naraprajwal/NeuraCorePCB/zynqPCB/images/blockdiagram_edited.png

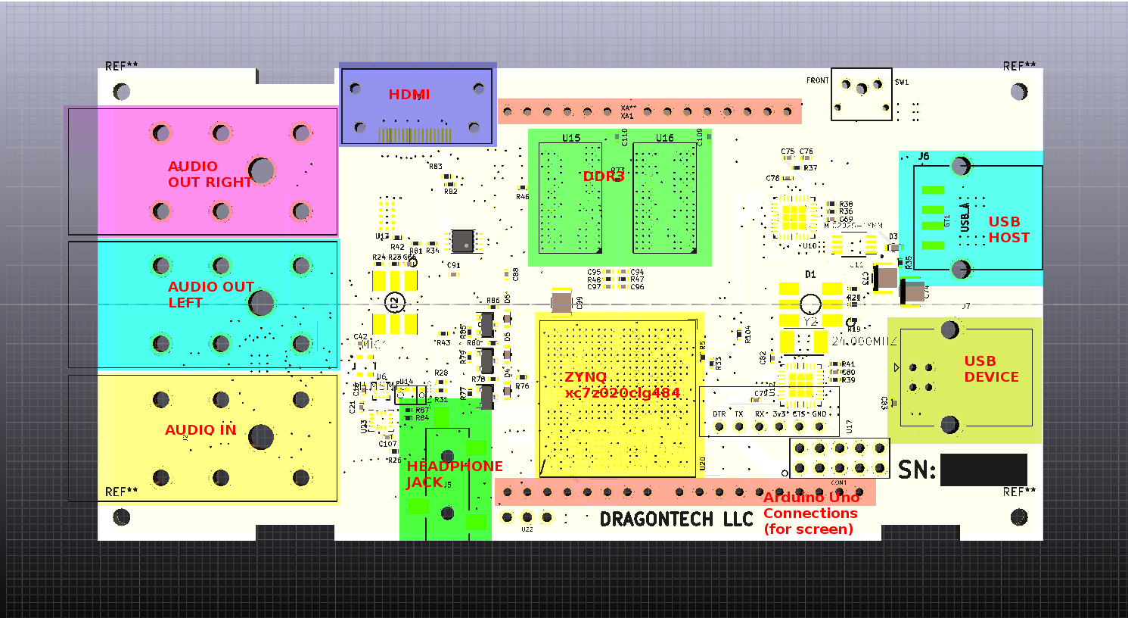
zynqPCB/images/blockdiagram_edited.png
