naraprajwal/NeuraCorePCB/zynqPCB/images/dt01_v3_bottom.jpg

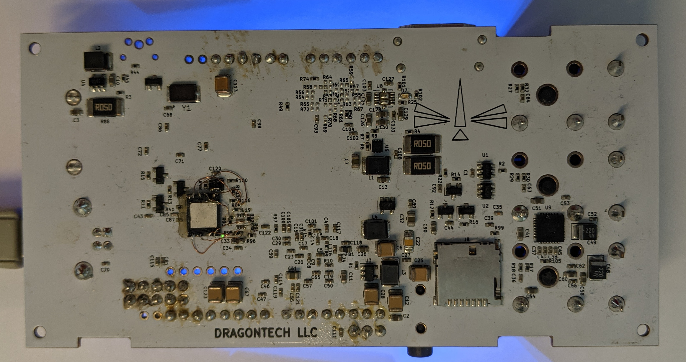
zynqPCB/images/dt01_v3_bottom.jpg
