naraprajwal/NeuraCorePCB/README.md

# NeuraCore-PCB
PCB design, Schematic, Libs etc
