naraprajwal/NeuraCorePCB/zynqPCB/docs/jackdetection.gif

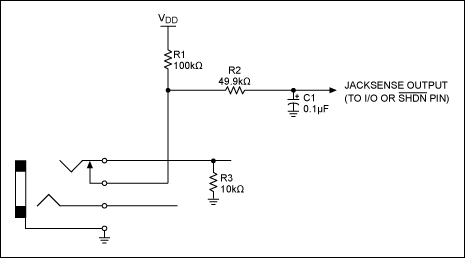
zynqPCB/docs/jackdetection.gif
