naraprajwal/NeuraCorePCB/zynqPCB/images/blockdiagram.PNG

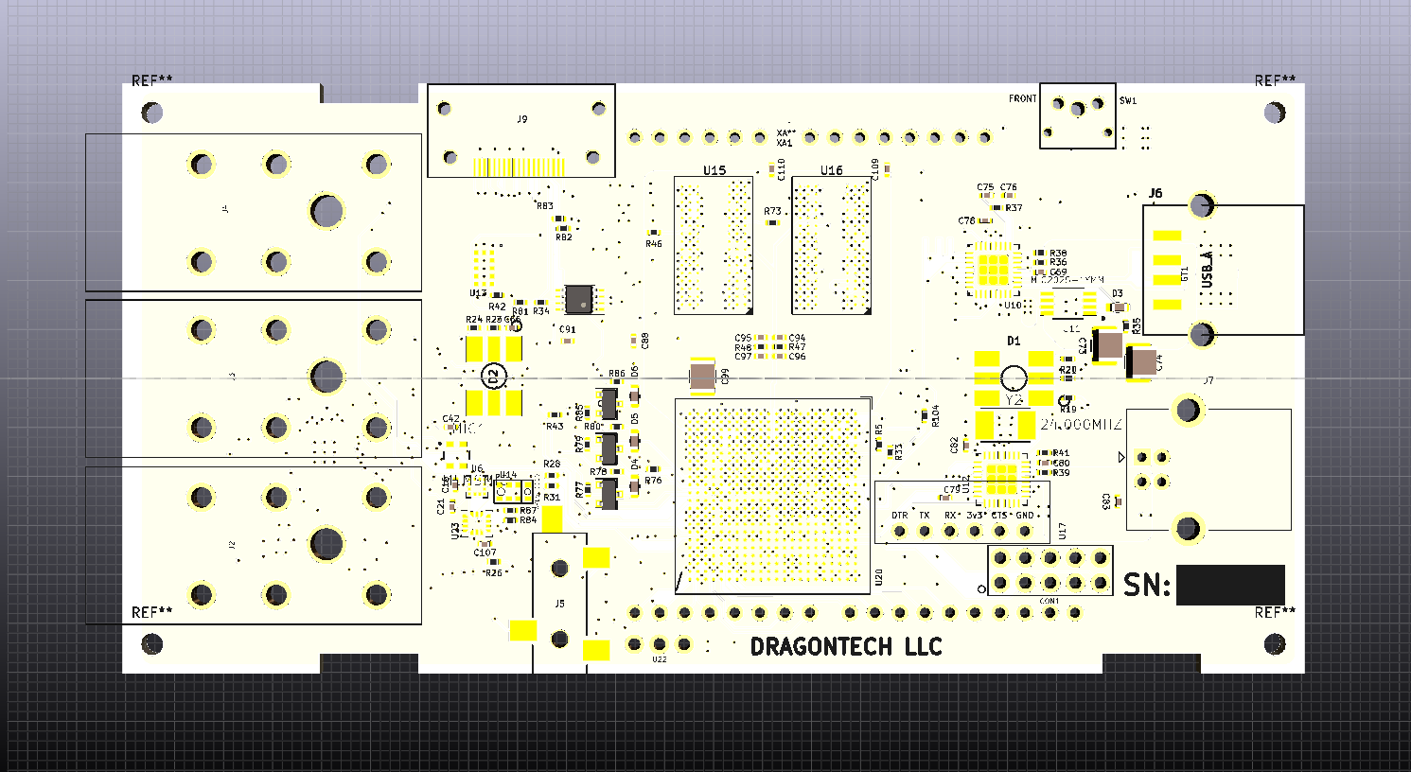
zynqPCB/images/blockdiagram.PNG
