naraprajwal/NeuraCorePCB/zynqPCB/images/dt01_3drender.PNG

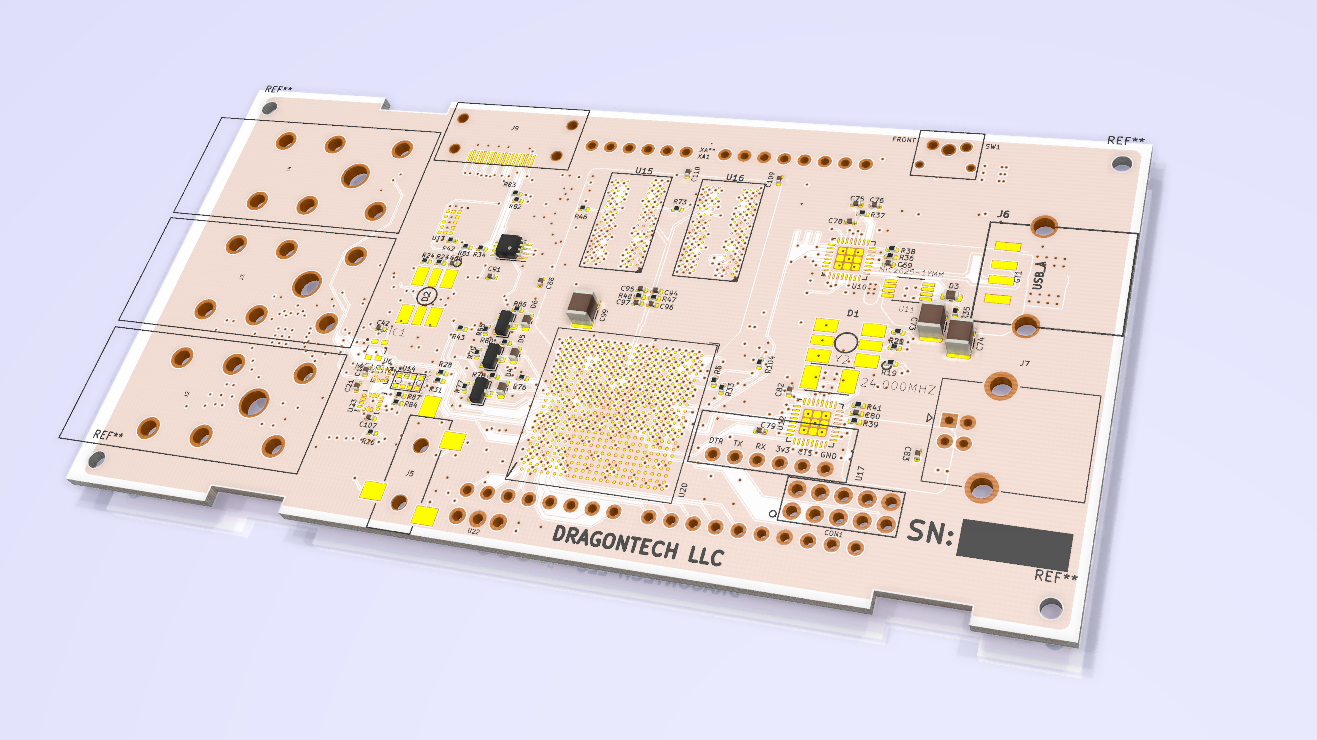
zynqPCB/images/dt01_3drender.PNG
