naraprajwal/NeuraCorePCB/zynqPCB/images/dt01_schematic.PNG

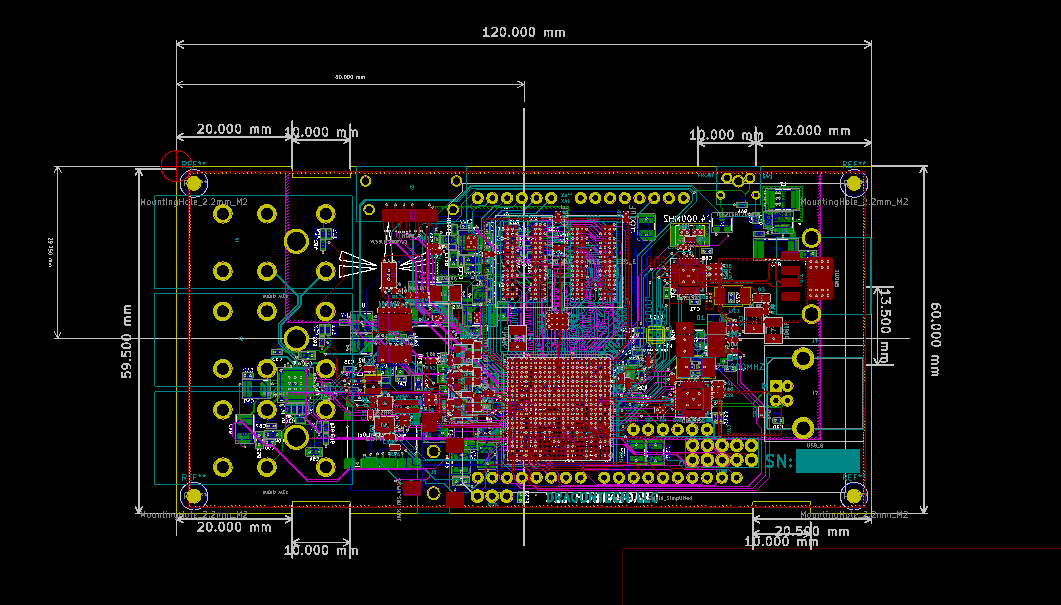
zynqPCB/images/dt01_schematic.PNG
