naraprajwal/NeuraCorePCB/zynqPCB/images/dt01_v3_top.jpg

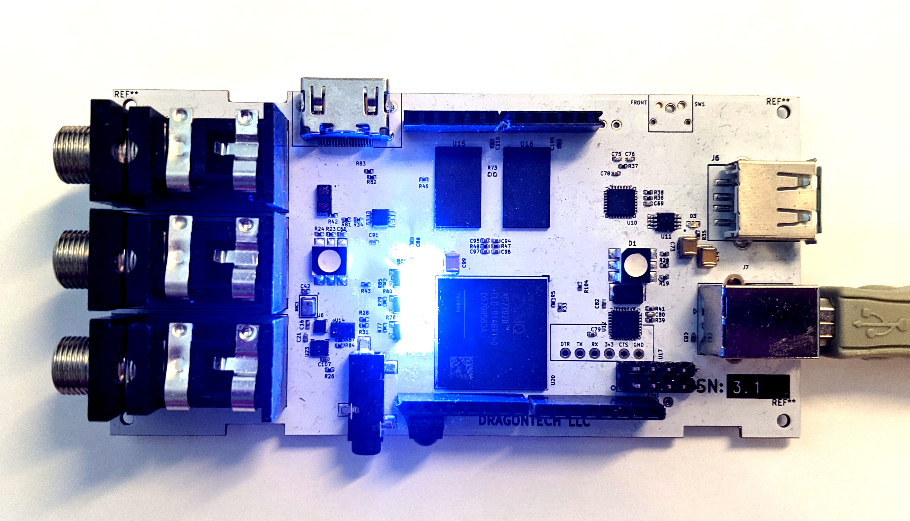
zynqPCB/images/dt01_v3_top.jpg
