naraprajwal/NeuraCorePCB/(list of files, drawings)

Other design files:
zynqPCB/DFTBoard.dsn
