naraprajwal/NeuraCorePCB/zynqPCB/Camera.kicad_sch

## KiCad design zynqPCB/Camera.kicad_sch (2026-04-15)

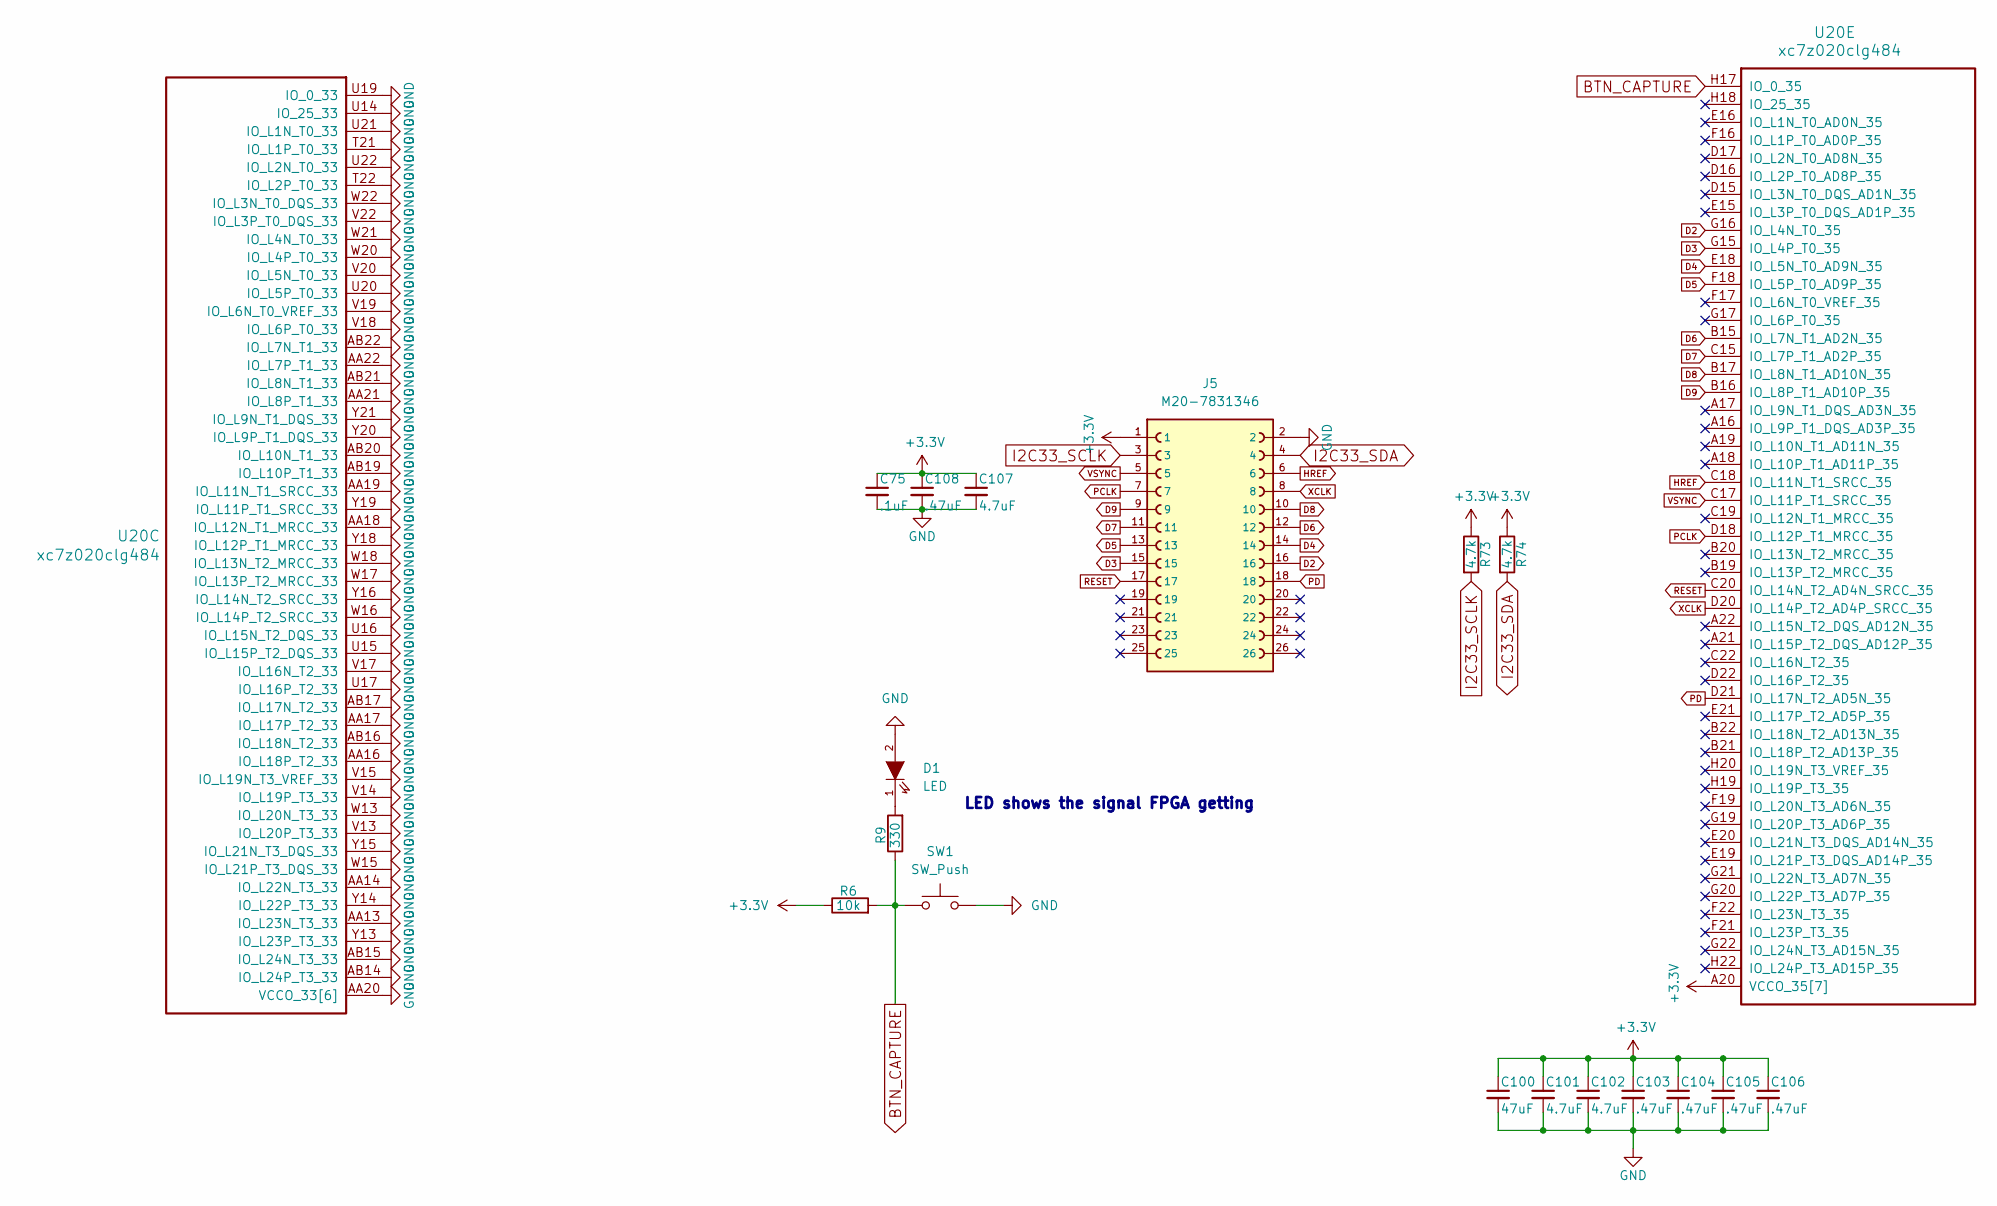
[picture p9: schematic Camera.kicad_sch]

Parts:
C75: .1uF; C_0402_1005Metric; MPN CC0402KRX7R6BB104
C100: 47uF; C_1210_3225Metric; MPN GRM32ER70J476ME20L
C101, C102, C107: 4.7uF; C_0402_1005Metric; MPN GRM155R60G475ME47D
C103, C104, C105, C106, C108: .47uF; C_0402_1005Metric; MPN CC0402KRX5R5BB474
D1: LED; LED_0603_1608Metric
J5: M20-7831346; HARWIN_M20-7831346; DigiKey_Part_Number 952-2548-ND
R6: 10k; R_0402_1005Metric
R9: 330; R_0603_1608Metric
R73, R74: 4.7k; R_0402_1005Metric; MPN RC0402JR-074K7L
SW1: SW_Push; SW_SPST_TL3342
U20: xc7z020clg484; BGA-484_19.0x19.0mm_Layout22x22_P0.80mm_dia0.40mm; MPN XC7Z020-1CLG484C

Connections:
+3.3V: C75.1, C100.1, C101.1, C102.1, C103.1, C104.1, C105.1, C106.1, C107.1, C108.1, J5.1, R6.1, R73.1, R74.1, U20.A20 (VCCO_35[7]), U20.C16 (VCCO_35[7]), U20.D19 (VCCO_35[7]), U20.E22 (VCCO_35[7]), U20.F15 (VCCO_35[7]), U20.G18 (VCCO_35[7]), U20.H21 (VCCO_35[7])
BTN_CAPTURE: R6.2, R9.1, SW1.1, U20.H17 (IO_0_35)
D2: J5.16, U20.G16 (IO_L4N_T0_35)
D3: J5.15, U20.G15 (IO_L4P_T0_35)
D4: J5.14, U20.E18 (IO_L5N_T0_AD9N_35)
D5: J5.13, U20.F18 (IO_L5P_T0_AD9P_35)
D6: J5.12, U20.B15 (IO_L7N_T1_AD2N_35)
D7: J5.11, U20.C15 (IO_L7P_T1_AD2P_35)
D8: J5.10, U20.B17 (IO_L8N_T1_AD10N_35)
D9: J5.9, U20.B16 (IO_L8P_T1_AD10P_35)
GND: C75.2, C100.2, C101.2, C102.2, C103.2, C104.2, C105.2, C106.2, C107.2, C108.2, D1.2 (A), J5.2, SW1.2, U20.AA13 (IO_L23N_T3_33), U20.AA14 (IO_L22N_T3_33), U20.AA16 (IO_L18P_T2_33), U20.AA17 (IO_L17P_T2_33), U20.AA18 (IO_L12N_T1_MRCC_33), U20.AA19 (IO_L11N_T1_SRCC_33), U20.AA20 (VCCO_33[6]), U20.AA21 (IO_L8P_T1_33), U20.AA22 (IO_L7P_T1_33), U20.AB13 (VCCO_33[6]), U20.AB14 (IO_L24P_T3_33), U20.AB15 (IO_L24N_T3_33), U20.AB16 (IO_L18N_T2_33), U20.AB17 (IO_L17N_T2_33), U20.AB19 (IO_L10P_T1_33), U20.AB20 (IO_L10N_T1_33), U20.AB21 (IO_L8N_T1_33), U20.AB22 (IO_L7N_T1_33), U20.T21 (IO_L1P_T0_33), U20.T22 (IO_L2P_T0_33), U20.U14 (IO_25_33), U20.U15 (IO_L15P_T2_DQS_33), U20.U16 (IO_L15N_T2_DQS_33), U20.U17 (IO_L16P_T2_33), U20.U18 (VCCO_33[6]), U20.U19 (IO_0_33), U20.U20 (IO_L5P_T0_33), U20.U21 (IO_L1N_T0_33), U20.U22 (IO_L2N_T0_33), U20.V13 (IO_L20P_T3_33), U20.V14 (IO_L19P_T3_33), U20.V15 (IO_L19N_T3_VREF_33), U20.V17 (IO_L16N_T2_33), U20.V18 (IO_L6P_T0_33), U20.V19 (IO_L6N_T0_VREF_33), U20.V20 (IO_L5N_T0_33), U20.V21 (VCCO_33[6]), U20.V22 (IO_L3P_T0_DQS_33), U20.W13 (IO_L20N_T3_33), U20.W14 (VCCO_33[6]), U20.W15 (IO_L21P_T3_DQS_33), U20.W16 (IO_L14P_T2_SRCC_33), U20.W17 (IO_L13P_T2_MRCC_33), U20.W18 (IO_L13N_T2_MRCC_33), U20.W20 (IO_L4P_T0_33), U20.W21 (IO_L4N_T0_33), U20.W22 (IO_L3N_T0_DQS_33), U20.Y13 (IO_L23P_T3_33), U20.Y14 (IO_L22P_T3_33), U20.Y15 (IO_L21N_T3_DQS_33), U20.Y16 (IO_L14N_T2_SRCC_33), U20.Y17 (VCCO_33[6]), U20.Y18 (IO_L12P_T1_MRCC_33), U20.Y19 (IO_L11P_T1_SRCC_33), U20.Y20 (IO_L9P_T1_DQS_33), U20.Y21 (IO_L9N_T1_DQS_33)
HREF: J5.6, U20.C18 (IO_L11N_T1_SRCC_35)
I2C33_SCLK: J5.3, R73.2
I2C33_SDA: J5.4, R74.2
unnamed: D1.1 (K), R9.2
PCLK: J5.7, U20.D18 (IO_L12P_T1_MRCC_35)
PD: J5.18, U20.D21 (IO_L17N_T2_AD5N_35)
RESET: J5.17, U20.C20 (IO_L14N_T2_AD4N_SRCC_35)
VSYNC: J5.5, U20.C17 (IO_L11P_T1_SRCC_35)
XCLK: J5.8, U20.D20 (IO_L14P_T2_AD4P_SRCC_35)

Notes on the sheet:
LED shows the signal FPGA getting
