naraprajwal/NeuraCorePCB/zynqPCB/DDR3.kicad_sch

## KiCad design zynqPCB/DDR3.kicad_sch (2026-04-15)

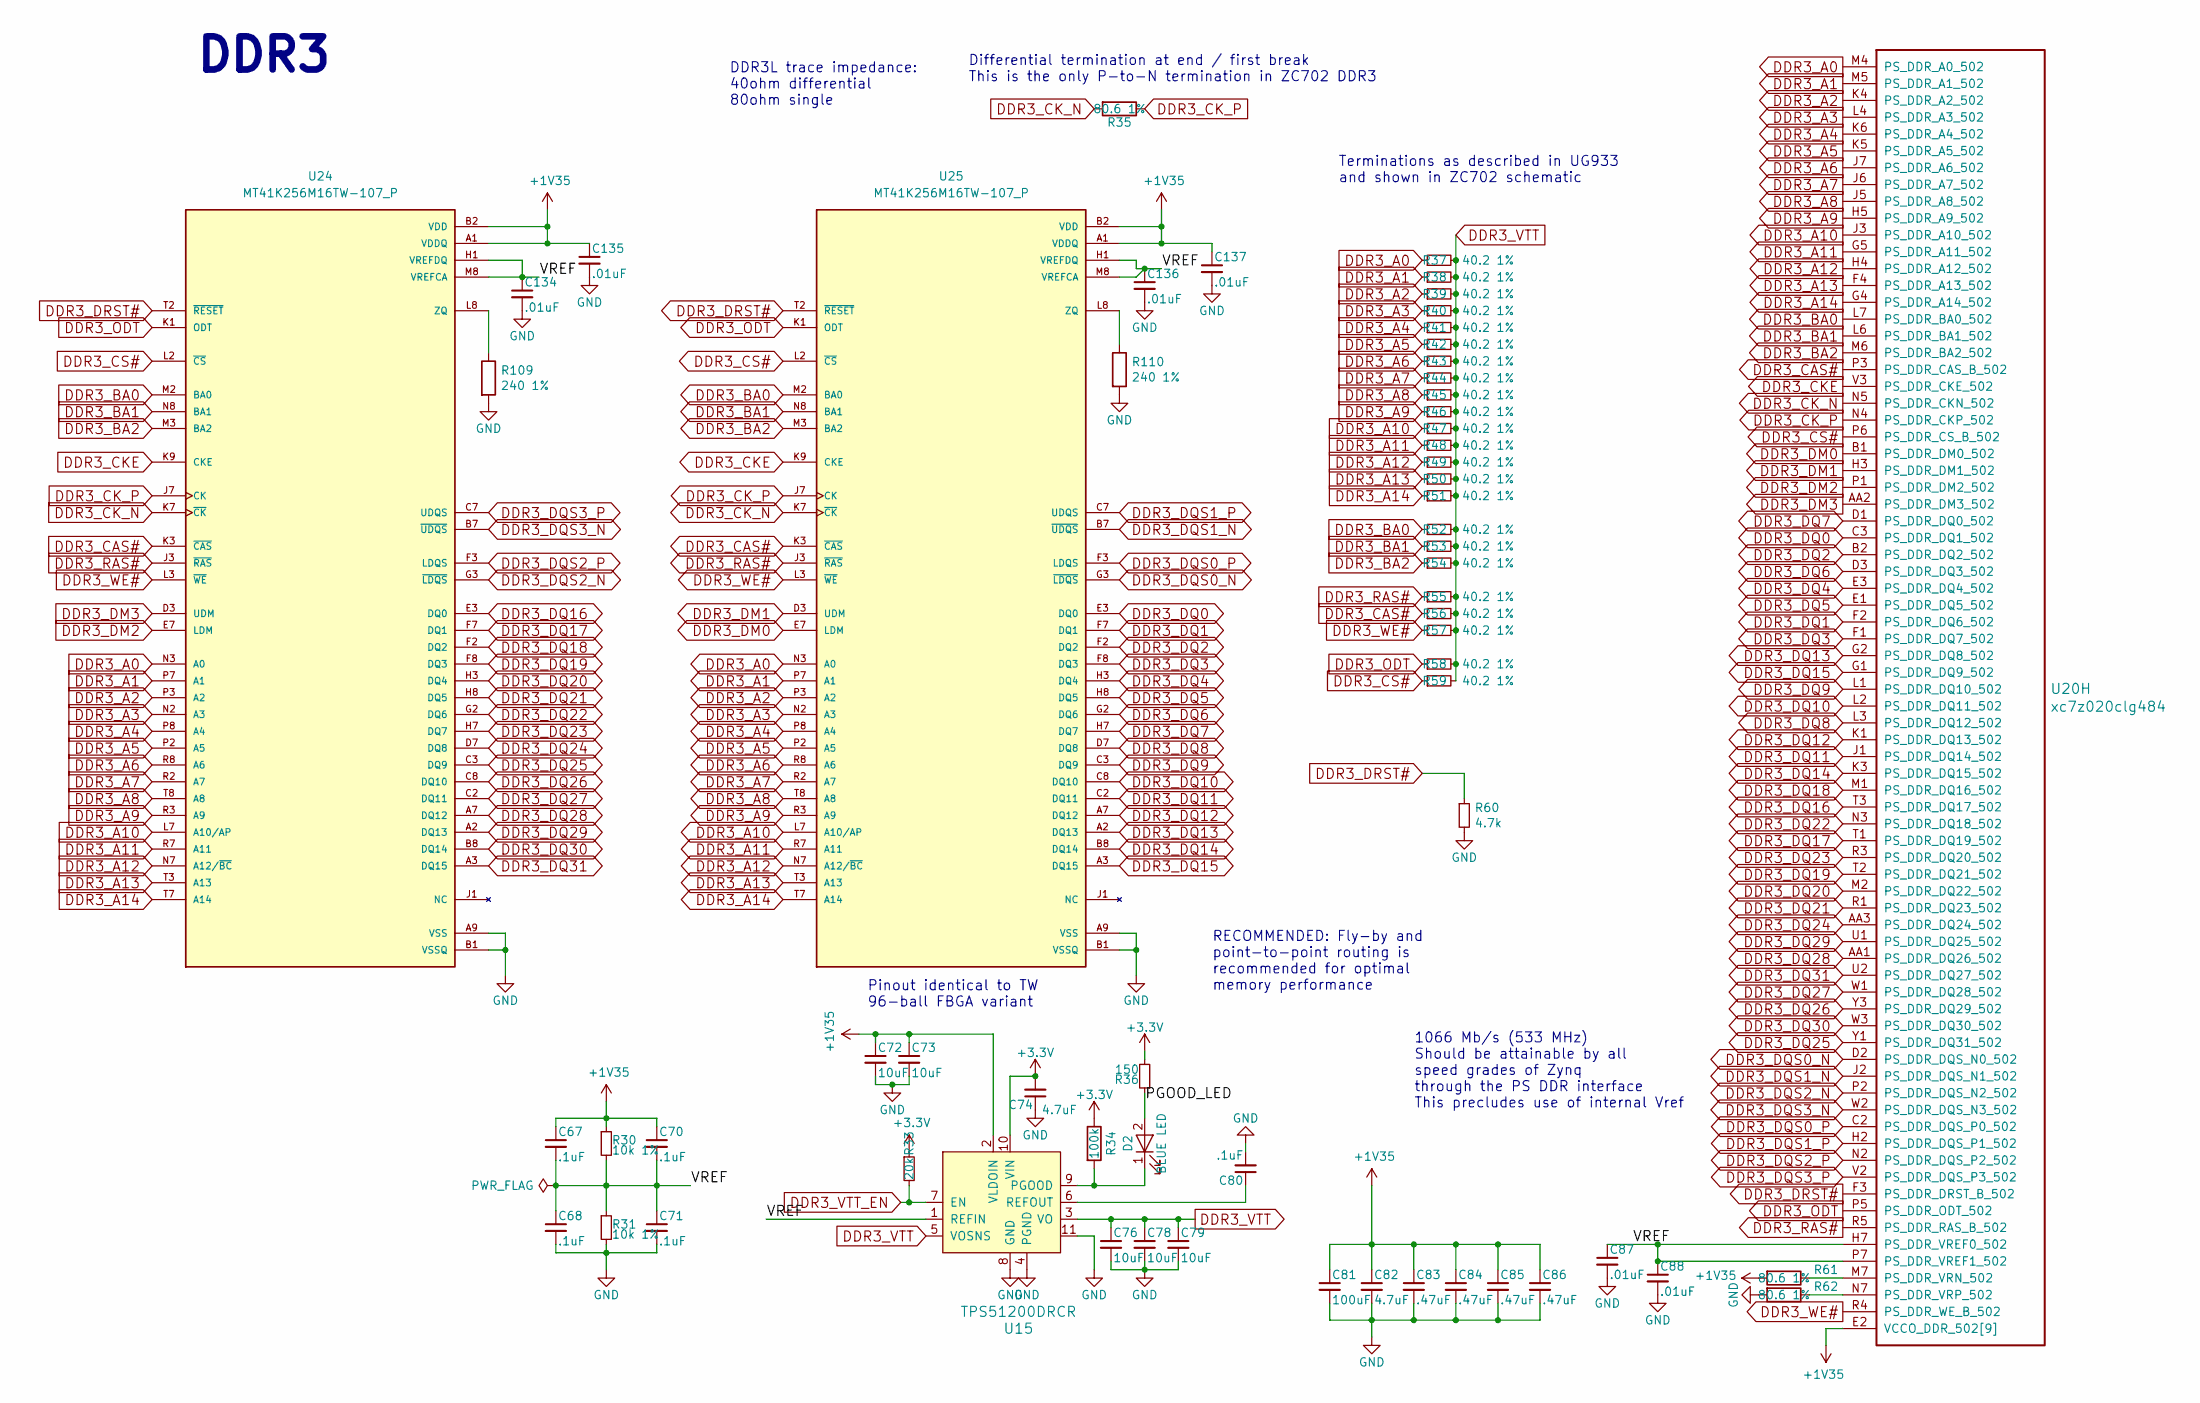
[picture p10: schematic DDR3.kicad_sch]

Parts:
C67, C68, C70, C71, C80: .1uF; C_0402_1005Metric; MPN CC0402KRX7R6BB104
C72, C73, C76, C78, C79: 10uF; C_0603_1608Metric; MPN GRM188R61A106KE69J
C74, C82: 4.7uF; C_0402_1005Metric; MPN GRM155R60G475ME47D
C81: 100uF; C_1210_3225Metric; MPN JMK325ABJ107MM-P
C83, C84, C85, C86: .47uF; C_0402_1005Metric; MPN CC0402KRX5R5BB474
C87, C88, C134, C135, C136, C137: .01uF; C_0402_1005Metric; MPN GRM155R71H103KA88J
D2: BLUE LED; C_0603_1608Metric; MPN VLMB1300-GS08
R30, R31: 10k 1%; R_0402_1005Metric; MPN RC0402FR-0710KL
R33: 20k; R_0402_1005Metric; MPN RT0402BRD0720KL
R34: 100k; R_0402_1005Metric; MPN RC0402FR-07100KL
R35, R61, R62: 80.6 1%; R_0402_1005Metric; MPN RC0402FR-0780R6L
R36: 150; R_0402_1005Metric; MPN RC0402FR-07150RL
R37, R38, R39, R40, R41, R42, R43, R44, R45, R46, R47, R48, R49, R50, R51, R52, R53, R54, R55, R56, R57, R58, R59: 40.2 1%; R_0402_1005Metric; MPN RC0402FR-0740R2L
R60: 4.7k; R_0402_1005Metric; MPN RC0402JR-074K7L
R109, R110: 240 1%; R_0402_1005Metric; MPN RC0402FR-07240RL
U15: TPS51200DRCR; VSON-10-1EP_3x3mm_P0.5mm_EP1.65x2.4mm_ThermalVias; MPN TPS51200DRCR; Digi-Key_PN 296-26978-1-ND
U20: xc7z020clg484; BGA-484_19.0x19.0mm_Layout22x22_P0.80mm_dia0.40mm; MPN XC7Z020-1CLG484C
U24, U25: MT41K256M16TW-107_P; MT41K256M16TW_107_P; PARTREV P; DigiKey_Part_Number 557-1792-ND

Connections:
+1V35: C67.1, C70.1, C72.1, C73.1, C81.1, C82.1, C83.1, C84.1, C85.1, C86.1, C135.1, C137.1, R30.1, R61.2, U15.2 (VLDOIN), U20.E2 (VCCO_DDR_502[9]), U20.F5 (VCCO_DDR_502[9]), U20.H1 (VCCO_DDR_502[9]), U20.J4 (VCCO_DDR_502[9]), U20.K7 (VCCO_DDR_502[9]), U20.M3 (VCCO_DDR_502[9]), U20.N6 (VCCO_DDR_502[9]), U20.R2 (VCCO_DDR_502[9]), U20.V1 (VCCO_DDR_502[9]), U24.A1 (VDDQ), U24.A8 (VDDQ), U24.B2 (VDD), U24.C1 (VDDQ), U24.C9 (VDDQ), U24.D2 (VDDQ), U24.D9 (VDD), U24.E9 (VDDQ), U24.F1 (VDDQ), U24.G7 (VDD), U24.H2 (VDDQ), U24.H9 (VDDQ), U24.K2 (VDD), U24.K8 (VDD), U24.N1 (VDD), U24.N9 (VDD), U24.R1 (VDD), U24.R9 (VDD), U25.A1 (VDDQ), U25.A8 (VDDQ), U25.B2 (VDD), U25.C1 (VDDQ), U25.C9 (VDDQ), U25.D2 (VDDQ), U25.D9 (VDD), U25.E9 (VDDQ), U25.F1 (VDDQ), U25.G7 (VDD), U25.H2 (VDDQ), U25.H9 (VDDQ), U25.K2 (VDD), U25.K8 (VDD), U25.N1 (VDD), U25.N9 (VDD), U25.R1 (VDD), U25.R9 (VDD)
+3.3V: C74.2, R33.1, R34.1, R36.2, U15.10 (VIN)
DDR3_A0: R37.1, U20.M4 (PS_DDR_A0_502), U24.N3 (A0), U25.N3 (A0)
DDR3_A1: R38.1, U20.M5 (PS_DDR_A1_502), U24.P7 (A1), U25.P7 (A1)
DDR3_A2: R39.1, U20.K4 (PS_DDR_A2_502), U24.P3 (A2), U25.P3 (A2)
DDR3_A3: R40.1, U20.L4 (PS_DDR_A3_502), U24.N2 (A3), U25.N2 (A3)
DDR3_A4: R41.1, U20.K6 (PS_DDR_A4_502), U24.P8 (A4), U25.P8 (A4)
DDR3_A5: R42.1, U20.K5 (PS_DDR_A5_502), U24.P2 (A5), U25.P2 (A5)
DDR3_A6: R43.1, U20.J7 (PS_DDR_A6_502), U24.R8 (A6), U25.R8 (A6)
DDR3_A7: R44.1, U20.J6 (PS_DDR_A7_502), U24.R2 (A7), U25.R2 (A7)
DDR3_A8: R45.1, U20.J5 (PS_DDR_A8_502), U24.T8 (A8), U25.T8 (A8)
DDR3_A9: R46.1, U20.H5 (PS_DDR_A9_502), U24.R3 (A9), U25.R3 (A9)
DDR3_A10: R47.1, U20.J3 (PS_DDR_A10_502), U24.L7 (A10/AP), U25.L7 (A10/AP)
DDR3_A11: R48.1, U20.G5 (PS_DDR_A11_502), U24.R7 (A11), U25.R7 (A11)
DDR3_A12: R49.1, U20.H4 (PS_DDR_A12_502), U24.N7 (A12/~BC), U25.N7 (A12/~BC)
DDR3_A13: R50.1, U20.F4 (PS_DDR_A13_502), U24.T3 (A13), U25.T3 (A13)
DDR3_A14: R51.1, U20.G4 (PS_DDR_A14_502), U24.T7 (A14), U25.T7 (A14)
DDR3_BA0: R52.1, U20.L7 (PS_DDR_BA0_502), U24.M2 (BA0), U25.M2 (BA0)
DDR3_BA1: R53.1, U20.L6 (PS_DDR_BA1_502), U24.N8 (BA1), U25.N8 (BA1)
DDR3_BA2: R54.1, U20.M6 (PS_DDR_BA2_502), U24.M3 (BA2), U25.M3 (BA2)
DDR3_CAS#: R56.1, U20.P3 (PS_DDR_CAS_B_502), U24.K3 (~CAS), U25.K3 (~CAS)
DDR3_CKE: U20.V3 (PS_DDR_CKE_502), U24.K9 (CKE), U25.K9 (CKE)
DDR3_CK_N: R35.2, U20.N5 (PS_DDR_CKN_502), U24.K7 (~CK), U25.K7 (~CK)
DDR3_CK_P: R35.1, U20.N4 (PS_DDR_CKP_502), U24.J7 (CK), U25.J7 (CK)
DDR3_CS#: R59.1, U20.P6 (PS_DDR_CS_B_502), U24.L2 (~CS), U25.L2 (~CS)
DDR3_DM0: U20.B1 (PS_DDR_DM0_502), U25.E7 (LDM)
DDR3_DM1: U20.H3 (PS_DDR_DM1_502), U25.D3 (UDM)
DDR3_DM2: U20.P1 (PS_DDR_DM2_502), U24.E7 (LDM)
DDR3_DM3: U20.AA2 (PS_DDR_DM3_502), U24.D3 (UDM)
DDR3_DQ0: U20.C3 (PS_DDR_DQ1_502), U25.E3 (DQ0)
DDR3_DQ1: U20.F2 (PS_DDR_DQ6_502), U25.F7 (DQ1)
DDR3_DQ2: U20.B2 (PS_DDR_DQ2_502), U25.F2 (DQ2)
DDR3_DQ3: U20.F1 (PS_DDR_DQ7_502), U25.F8 (DQ3)
DDR3_DQ4: U20.E3 (PS_DDR_DQ4_502), U25.H3 (DQ4)
DDR3_DQ5: U20.E1 (PS_DDR_DQ5_502), U25.H8 (DQ5)
DDR3_DQ6: U20.D3 (PS_DDR_DQ3_502), U25.G2 (DQ6)
DDR3_DQ7: U20.D1 (PS_DDR_DQ0_502), U25.H7 (DQ7)
DDR3_DQ8: U20.L3 (PS_DDR_DQ12_502), U25.D7 (DQ8)
DDR3_DQ9: U20.L1 (PS_DDR_DQ10_502), U25.C3 (DQ9)
DDR3_DQ10: U20.L2 (PS_DDR_DQ11_502), U25.C8 (DQ10)
DDR3_DQ11: U20.J1 (PS_DDR_DQ14_502), U25.C2 (DQ11)
DDR3_DQ12: U20.K1 (PS_DDR_DQ13_502), U25.A7 (DQ12)
DDR3_DQ13: U20.G2 (PS_DDR_DQ8_502), U25.A2 (DQ13)
DDR3_DQ14: U20.K3 (PS_DDR_DQ15_502), U25.B8 (DQ14)
DDR3_DQ15: U20.G1 (PS_DDR_DQ9_502), U25.A3 (DQ15)
DDR3_DQ16: U20.T3 (PS_DDR_DQ17_502), U24.E3 (DQ0)
DDR3_DQ17: U20.T1 (PS_DDR_DQ19_502), U24.F7 (DQ1)
DDR3_DQ18: U20.M1 (PS_DDR_DQ16_502), U24.F2 (DQ2)
DDR3_DQ19: U20.T2 (PS_DDR_DQ21_502), U24.F8 (DQ3)
DDR3_DQ20: U20.M2 (PS_DDR_DQ22_502), U24.H3 (DQ4)
DDR3_DQ21: U20.R1 (PS_DDR_DQ23_502), U24.H8 (DQ5)
DDR3_DQ22: U20.N3 (PS_DDR_DQ18_502), U24.G2 (DQ6)
DDR3_DQ23: U20.R3 (PS_DDR_DQ20_502), U24.H7 (DQ7)
DDR3_DQ24: U20.AA3 (PS_DDR_DQ24_502), U24.D7 (DQ8)
DDR3_DQ25: U20.Y1 (PS_DDR_DQ31_502), U24.C3 (DQ9)
DDR3_DQ26: U20.Y3 (PS_DDR_DQ29_502), U24.C8 (DQ10)
DDR3_DQ27: U20.W1 (PS_DDR_DQ28_502), U24.C2 (DQ11)
DDR3_DQ28: U20.AA1 (PS_DDR_DQ26_502), U24.A7 (DQ12)
DDR3_DQ29: U20.U1 (PS_DDR_DQ25_502), U24.A2 (DQ13)
DDR3_DQ30: U20.W3 (PS_DDR_DQ30_502), U24.B8 (DQ14)
DDR3_DQ31: U20.U2 (PS_DDR_DQ27_502), U24.A3 (DQ15)
DDR3_DQS0_N: U20.D2 (PS_DDR_DQS_N0_502), U25.G3 (~LDQS)
DDR3_DQS0_P: U20.C2 (PS_DDR_DQS_P0_502), U25.F3 (LDQS)
DDR3_DQS1_N: U20.J2 (PS_DDR_DQS_N1_502), U25.B7 (~UDQS)
DDR3_DQS1_P: U20.H2 (PS_DDR_DQS_P1_502), U25.C7 (UDQS)
DDR3_DQS2_N: U20.P2 (PS_DDR_DQS_N2_502), U24.G3 (~LDQS)
DDR3_DQS2_P: U20.N2 (PS_DDR_DQS_P2_502), U24.F3 (LDQS)
DDR3_DQS3_N: U20.W2 (PS_DDR_DQS_N3_502), U24.B7 (~UDQS)
DDR3_DQS3_P: U20.V2 (PS_DDR_DQS_P3_502), U24.C7 (UDQS)
DDR3_DRST#: R60.1, U20.F3 (PS_DDR_DRST_B_502), U24.T2 (~RESET), U25.T2 (~RESET)
DDR3_ODT: R58.1, U20.P5 (PS_DDR_ODT_502), U24.K1 (ODT), U25.K1 (ODT)
DDR3_RAS#: R55.1, U20.R5 (PS_DDR_RAS_B_502), U24.J3 (~RAS), U25.J3 (~RAS)
DDR3_VTT: C76.1, C78.1, C79.1, R37.2, R38.2, R39.2, R40.2, R41.2, R42.2, R43.2, R44.2, R45.2, R46.2, R47.2, R48.2, R49.2, R50.2, R51.2, R52.2, R53.2, R54.2, R55.2, R56.2, R57.2, R58.2, R59.2, U15.3 (VO), U15.5 (VOSNS)
DDR3_VTT_EN: R33.2, U15.7 (EN)
DDR3_WE#: R57.1, U20.R4 (PS_DDR_WE_B_502), U24.L3 (~WE), U25.L3 (~WE)
GND: C68.2, C71.2, C72.2, C73.2, C74.1, C76.2, C78.2, C79.2, C80.2, C81.2, C82.2, C83.2, C84.2, C85.2, C86.2, C87.2, C88.2, C134.2, C135.2, C136.2, C137.2, R31.2, R60.2, R62.2, R109.2, R110.2, U15.4 (PGND), U15.8 (GND), U15.11, U24.A9 (VSS), U24.B1 (VSSQ), U24.B3 (VSS), U24.B9 (VSSQ), U24.D1 (VSSQ), U24.D8 (VSSQ), U24.E1 (VSS), U24.E2 (VSSQ), U24.E8 (VSSQ), U24.F9 (VSSQ), U24.G1 (VSSQ), U24.G8 (VSS), U24.G9 (VSSQ), U24.J2 (VSS), U24.J8 (VSS), U24.M1 (VSS), U24.M9 (VSS), U24.P1 (VSS), U24.P9 (VSS), U24.T1 (VSS), U24.T9 (VSS), U25.A9 (VSS), U25.B1 (VSSQ), U25.B3 (VSS), U25.B9 (VSSQ), U25.D1 (VSSQ), U25.D8 (VSSQ), U25.E1 (VSS), U25.E2 (VSSQ), U25.E8 (VSSQ), U25.F9 (VSSQ), U25.G1 (VSSQ), U25.G8 (VSS), U25.G9 (VSSQ), U25.J2 (VSS), U25.J8 (VSS), U25.M1 (VSS), U25.M9 (VSS), U25.P1 (VSS), U25.P9 (VSS), U25.T1 (VSS), U25.T9 (VSS)
unnamed: C80.1, U15.6 (REFOUT)
unnamed: D2.1 (K), R34.2, U15.9 (PGOOD)
unnamed: R61.1, U20.M7 (PS_DDR_VRN_502)
unnamed: R62.1, U20.N7 (PS_DDR_VRP_502)
unnamed: R109.1, U24.L8 (ZQ)
unnamed: R110.1, U25.L8 (ZQ)
unnamed: U24.J1 (NC), U24.J9 (NC), U24.L1 (NC), U24.L9 (NC), U24.M7 (NC)
unnamed: U25.J1 (NC), U25.J9 (NC), U25.L1 (NC), U25.L9 (NC), U25.M7 (NC)
PGOOD_LED: D2.2 (A), R36.1
VREF: C67.2, C68.1, C70.2, C71.1, C87.1, C88.1, C134.1, C136.1, R30.2, R31.1, U15.1 (REFIN), U20.H7 (PS_DDR_VREF0_502), U20.P7 (PS_DDR_VREF1_502), U24.H1 (VREFDQ), U24.M8 (VREFCA), U25.H1 (VREFDQ), U25.M8 (VREFCA)

Notes on the sheet:
1066 Mb/s (533 MHz) Should be attainable by all speed grades of Zynq through the PS DDR interface This precludes use of internal Vref
Pinout identical to TW 96-ball FBGA variant
DDR3L trace impedance: 40ohm differential 80ohm single
DDR3
RECOMMENDED: Fly-by and point-to-point routing is recommended for optimal memory performance
Terminations as described in UG933 and shown in ZC702 schematic
Differential termination at end / first break This is the only P-to-N termination in ZC702 DDR3
