naraprajwal/NeuraCorePCB/zynqPCB/HDMI.kicad_sch

## KiCad design zynqPCB/HDMI.kicad_sch (2026-04-15)

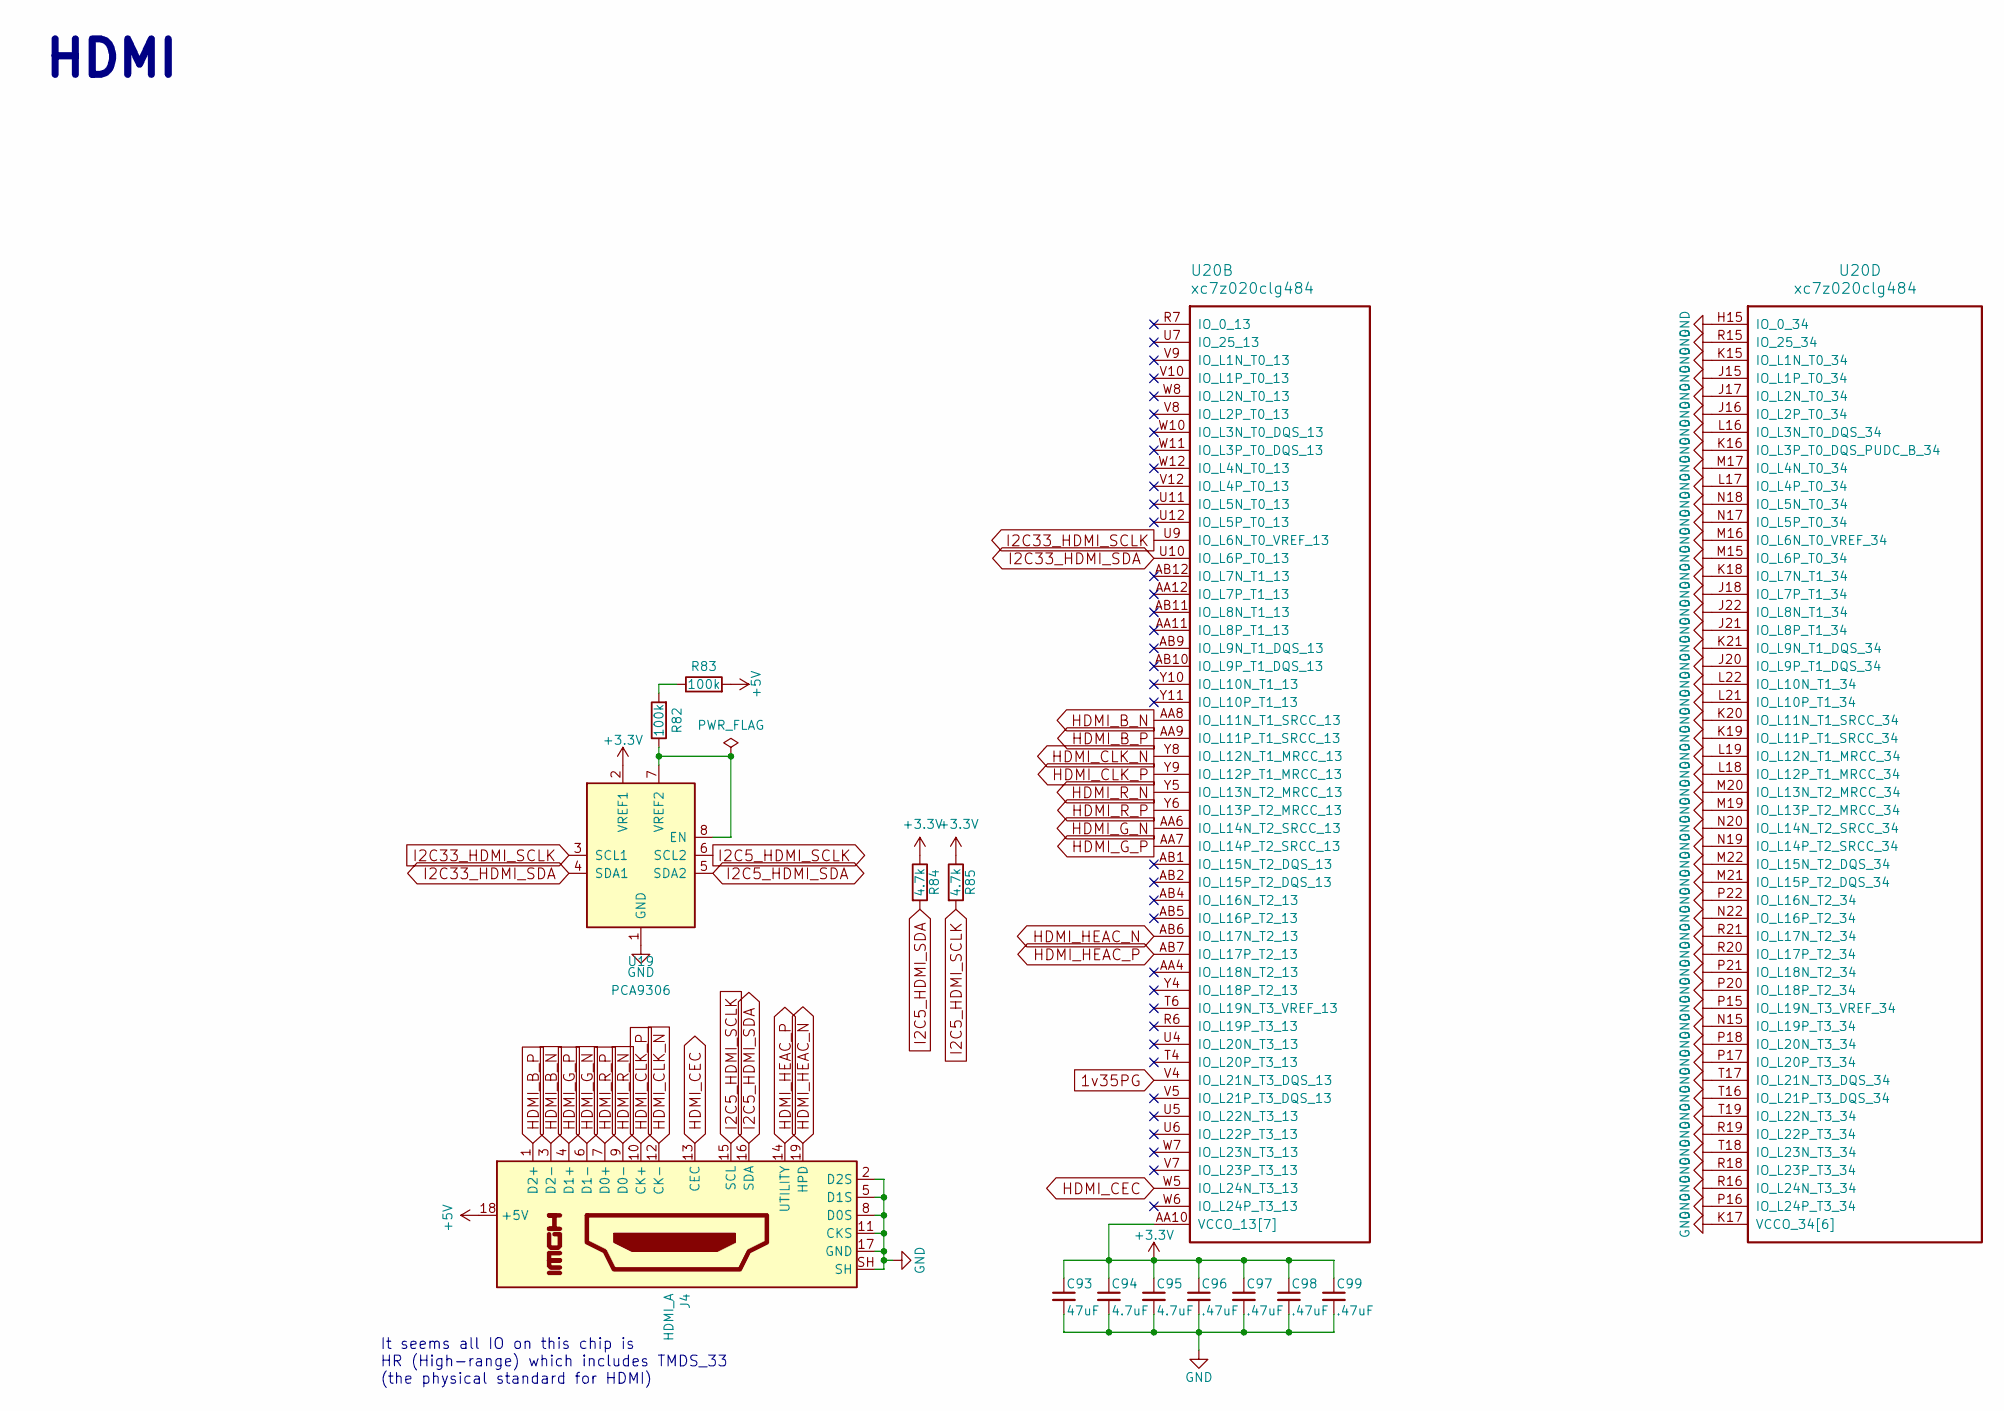
[picture p11: schematic HDMI.kicad_sch]

Parts:
C93: 47uF; C_1210_3225Metric; MPN GRM32ER70J476ME20L
C94, C95: 4.7uF; C_0402_1005Metric; MPN GRM155R60G475ME47D
C96, C97, C98, C99: .47uF; C_0402_1005Metric; MPN CC0402KRX5R5BB474
J4: HDMI_A; 10029449-111RLF; MPN 10029449-111RLF
R82, R83: 100k; R_0402_1005Metric; MPN RC0402FR-07100KL
R84, R85: 4.7k; R_0402_1005Metric; MPN RC0402JR-074K7L
U19: PCA9306; SSOP-8_2.95x2.8mm_P0.65mm; MPN PCA9306DCTR
U20: xc7z020clg484; BGA-484_19.0x19.0mm_Layout22x22_P0.80mm_dia0.40mm; MPN XC7Z020-1CLG484C

Connections:
1v35PG: U20.V4 (IO_L21N_T3_DQS_13)
+3.3V: C93.1, C94.1, C95.1, C96.1, C97.1, C98.1, C99.1, R84.1, R85.1, U19.2 (VREF1), U20.AA10 (VCCO_13[7]), U20.AB3 (VCCO_13[7]), U20.T5 (VCCO_13[7]), U20.U8 (VCCO_13[7]), U20.V11 (VCCO_13[7]), U20.W4 (VCCO_13[7]), U20.Y7 (VCCO_13[7])
+5V: J4.18 (+5V), R83.2
GND: C93.2, C94.2, C95.2, C96.2, C97.2, C98.2, C99.2, J4.2 (D2S), J4.5 (D1S), J4.8 (D0S), J4.11 (CKS), J4.17 (GND), J4.SH, U19.1 (GND), U20.H15 (IO_0_34), U20.J15 (IO_L1P_T0_34), U20.J16 (IO_L2P_T0_34), U20.J17 (IO_L2N_T0_34), U20.J18 (IO_L7P_T1_34), U20.J20 (IO_L9P_T1_DQS_34), U20.J21 (IO_L8P_T1_34), U20.J22 (IO_L8N_T1_34), U20.K15 (IO_L1N_T0_34), U20.K16 (IO_L3P_T0_DQS_PUDC_B_34), U20.K17 (VCCO_34[6]), U20.K18 (IO_L7N_T1_34), U20.K19 (IO_L11P_T1_SRCC_34), U20.K20 (IO_L11N_T1_SRCC_34), U20.K21 (IO_L9N_T1_DQS_34), U20.L16 (IO_L3N_T0_DQS_34), U20.L17 (IO_L4P_T0_34), U20.L18 (IO_L12P_T1_MRCC_34), U20.L19 (IO_L12N_T1_MRCC_34), U20.L20 (VCCO_34[6]), U20.L21 (IO_L10P_T1_34), U20.L22 (IO_L10N_T1_34), U20.M15 (IO_L6P_T0_34), U20.M16 (IO_L6N_T0_VREF_34), U20.M17 (IO_L4N_T0_34), U20.M19 (IO_L13P_T2_MRCC_34), U20.M20 (IO_L13N_T2_MRCC_34), U20.M21 (IO_L15P_T2_DQS_34), U20.M22 (IO_L15N_T2_DQS_34), U20.N15 (IO_L19P_T3_34), U20.N16 (VCCO_34[6]), U20.N17 (IO_L5P_T0_34), U20.N18 (IO_L5N_T0_34), U20.N19 (IO_L14P_T2_SRCC_34), U20.N20 (IO_L14N_T2_SRCC_34), U20.N22 (IO_L16P_T2_34), U20.P15 (IO_L19N_T3_VREF_34), U20.P16 (IO_L24P_T3_34), U20.P17 (IO_L20P_T3_34), U20.P18 (IO_L20N_T3_34), U20.P19 (VCCO_34[6]), U20.P20 (IO_L18P_T2_34), U20.P21 (IO_L18N_T2_34), U20.P22 (IO_L16N_T2_34), U20.R15 (IO_25_34), U20.R16 (IO_L24N_T3_34), U20.R18 (IO_L23P_T3_34), U20.R19 (IO_L22P_T3_34), U20.R20 (IO_L17P_T2_34), U20.R21 (IO_L17N_T2_34), U20.R22 (VCCO_34[6]), U20.T15 (VCCO_34[6]), U20.T16 (IO_L21P_T3_DQS_34), U20.T17 (IO_L21N_T3_DQS_34), U20.T18 (IO_L23N_T3_34), U20.T19 (IO_L22N_T3_34)
HDMI_B_N: J4.3 (D2-), U20.AA8 (IO_L11N_T1_SRCC_13)
HDMI_B_P: J4.1 (D2+), U20.AA9 (IO_L11P_T1_SRCC_13)
HDMI_CEC: J4.13 (CEC), U20.W5 (IO_L24N_T3_13)
HDMI_CLK_N: J4.12 (CK-), U20.Y8 (IO_L12N_T1_MRCC_13)
HDMI_CLK_P: J4.10 (CK+), U20.Y9 (IO_L12P_T1_MRCC_13)
HDMI_G_N: J4.6 (D1-), U20.AA6 (IO_L14N_T2_SRCC_13)
HDMI_G_P: J4.4 (D1+), U20.AA7 (IO_L14P_T2_SRCC_13)
HDMI_HEAC_N: J4.19 (HPD), U20.AB6 (IO_L17N_T2_13)
HDMI_HEAC_P: J4.14 (UTILITY), U20.AB7 (IO_L17P_T2_13)
HDMI_R_N: J4.9 (D0-), U20.Y5 (IO_L13N_T2_MRCC_13)
HDMI_R_P: J4.7 (D0+), U20.Y6 (IO_L13P_T2_MRCC_13)
I2C5_HDMI_SCLK: J4.15 (SCL), R85.2, U19.6 (SCL2)
I2C5_HDMI_SDA: J4.16 (SDA), R84.2, U19.5 (SDA2)
I2C33_HDMI_SCLK: U19.3 (SCL1), U20.U9 (IO_L6N_T0_VREF_13)
I2C33_HDMI_SDA: U19.4 (SDA1), U20.U10 (IO_L6P_T0_13)
unnamed: R82.1, U19.7 (VREF2), U19.8 (EN)
unnamed: R82.2, R83.1

Notes on the sheet:
HDMI
It seems all IO on this chip is HR (High-range) which includes TMDS_33 (the physical standard for HDMI)
