naraprajwal/NeuraCorePCB/zynqPCB/Power_input_usb-c.kicad_sch

## KiCad design zynqPCB/Power_input_usb-c.kicad_sch (2026-04-15)

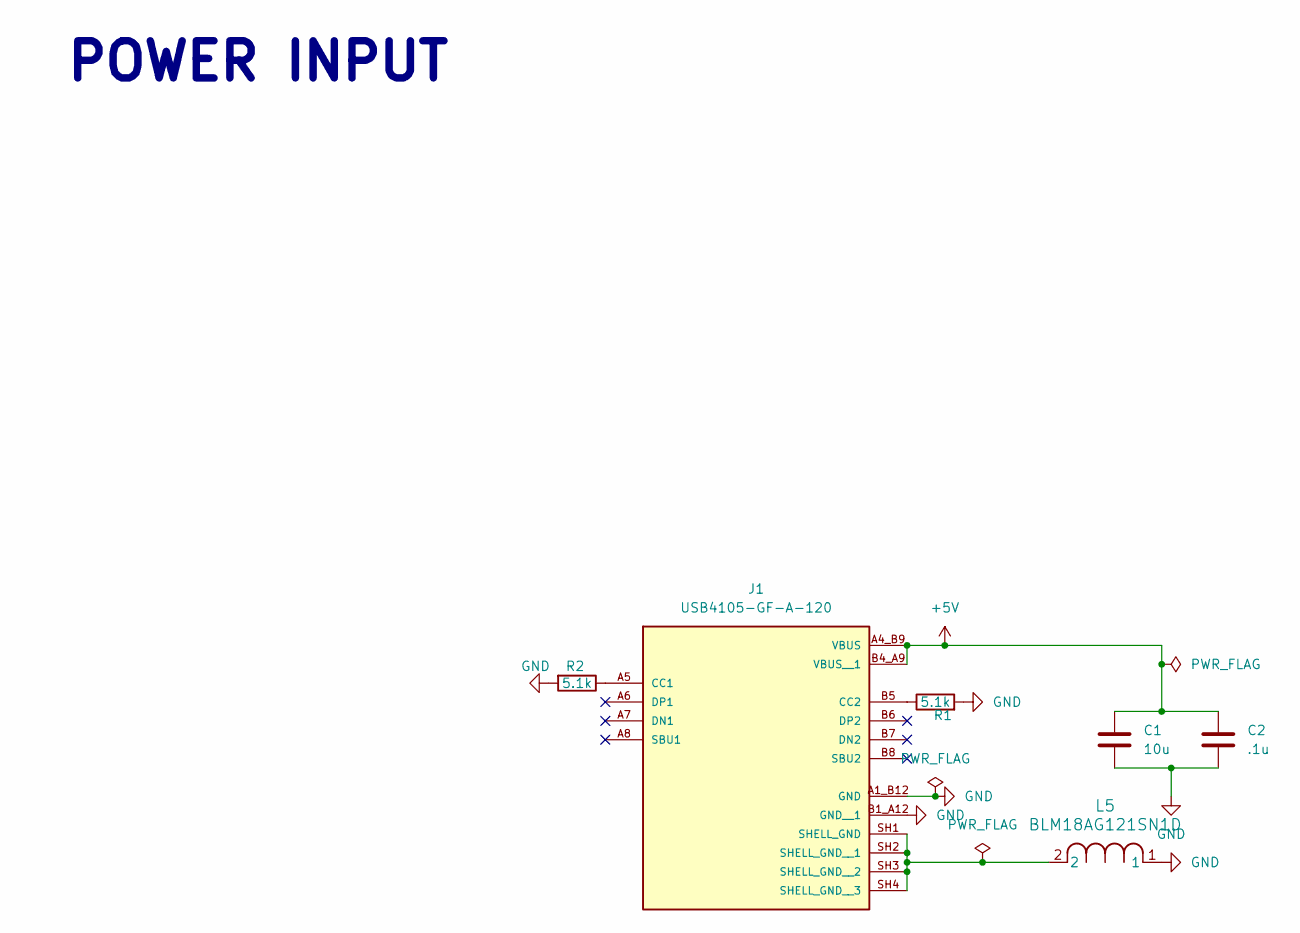
[picture p12: schematic Power_input_usb-c.kicad_sch]

Parts:
C1: 10u; C_0603_1608Metric
C2: .1u; C_0402_1005Metric
J1: USB4105-GF-A-120; GCT_USB4105-GF-A-120; PARTREV B3
L5: BLM18AG121SN1D; IND_BLM18_0603_MUR-L
R1, R2: 5.1k; R_0402_1005Metric

Connections:
+5V: C1.1, C2.1, J1.A4_B9 (VBUS), J1.B4_A9 (VBUS__1)
GND: C1.2, C2.2, J1.A1_B12 (GND), J1.B1_A12 (GND__1), L5.1, R1.2, R2.2
unnamed: J1.A5 (CC1), R2.1
unnamed: J1.B5 (CC2), R1.1
unnamed: J1.SH1 (SHELL_GND), J1.SH2 (SHELL_GND__1), J1.SH3 (SHELL_GND__2), J1.SH4 (SHELL_GND__3), L5.2

Notes on the sheet:
POWER INPUT
