naraprajwal/NeuraCorePCB/zynqPCB/Storage.kicad_sch

## KiCad design zynqPCB/Storage.kicad_sch (2026-04-14)

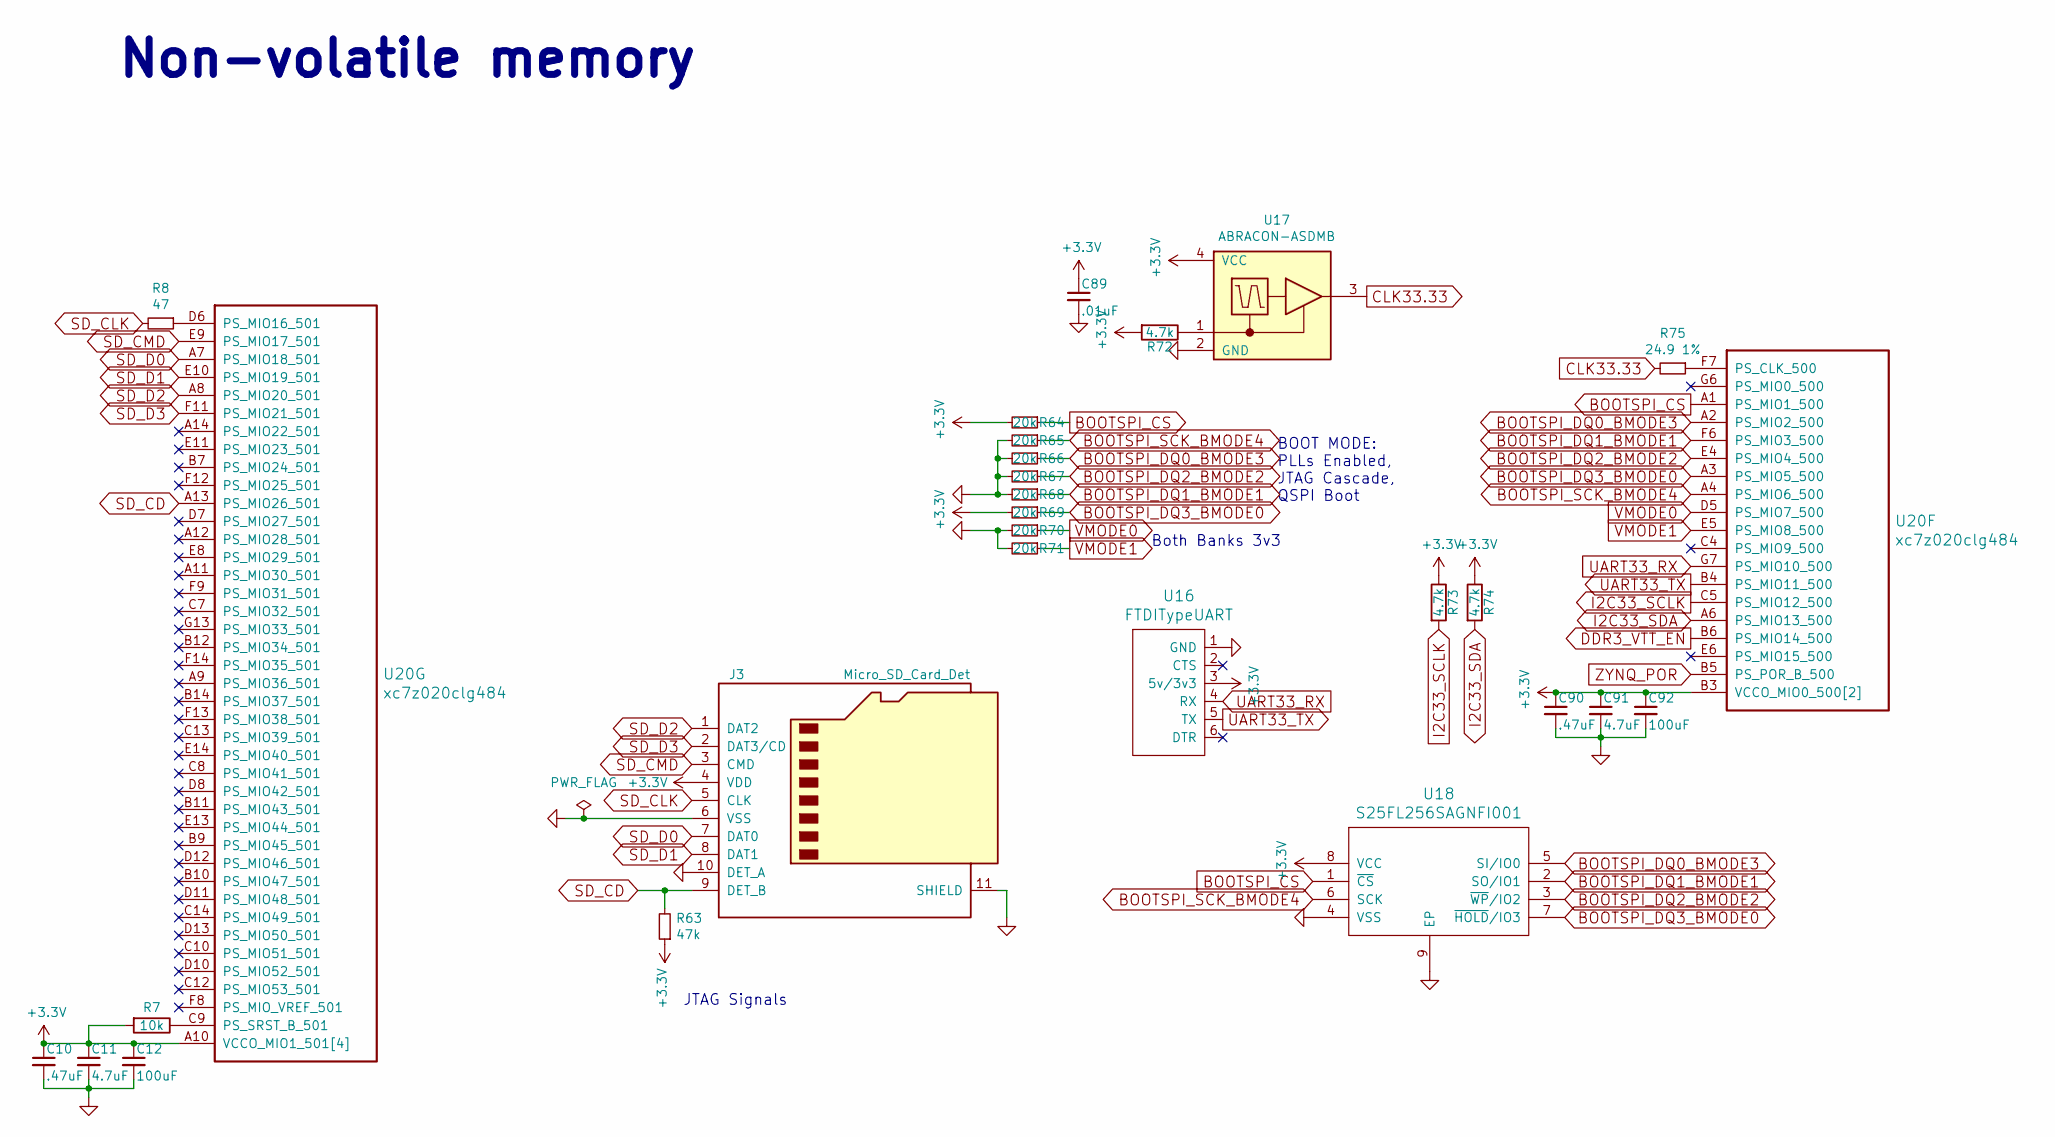
[picture p13: schematic Storage.kicad_sch]

Parts:
C10, C90: .47uF; C_0402_1005Metric; MPN CC0402KRX5R5BB474
C11, C91: 4.7uF; C_0402_1005Metric; MPN GRM155R60G475ME47D
C12, C92: 100uF; C_1210_3225Metric; MPN JMK325ABJ107MM-P
C89: .01uF; C_0402_1005Metric; MPN GRM155R71H103KA88J
J3: Micro_SD_Card_Det; AMPHENOL-114-00841-68; MPN 114-00841-68
R7: 10k; R_0402_1005Metric; MPN RC0402FR-0710KL
R8: 47; R_0402_1005Metric; MPN RC0402JR-0747RL
R63: 47k; R_0402_1005Metric; MPN RC0402FR-0747KL
R64, R65, R66, R67, R68, R69, R70, R71: 20k; R_0402_1005Metric; MPN RT0402BRD0720KL
R72, R73, R74: 4.7k; R_0402_1005Metric; MPN RC0402JR-074K7L
R75: 24.9 1%; R_0402_1005Metric; MPN RC0402FR-0724K9L
U16: FTDITypeUART; FTDI_CONN
U17: ABRACON-ASDMB; XTAL_ASDMB-24.000MHZ-LC-T; MPN ASDMB-24.000MHZ-LC-T
U18: S25FL256SAGNFI001; Cypress-002-18827-0-0-0; MPN S25FL256SAGNFI001
U20: xc7z020clg484; BGA-484_19.0x19.0mm_Layout22x22_P0.80mm_dia0.40mm; MPN XC7Z020-1CLG484C

Connections:
+3.3V: C10.1, C11.1, C12.1, C89.1, C90.1, C91.1, C92.1, J3.4 (VDD), R7.2, R63.1, R64.2, R69.2, R72.2, R73.1, R74.1, U16.3 (5v/3v3), U17.4 (VCC), U18.8 (VCC), U20.A10 (VCCO_MIO1_501[4]), U20.B3 (VCCO_MIO0_500[2]), U20.B13 (VCCO_MIO1_501[4]), U20.C6 (VCCO_MIO0_500[2]), U20.D9 (VCCO_MIO1_501[4]), U20.E12 (VCCO_MIO1_501[4])
BOOTSPI_CS: R64.1, U18.1 (~CS), U20.A1 (PS_MIO1_500)
BOOTSPI_DQ0_BMODE3: R66.1, U18.5 (SI/IO0), U20.A2 (PS_MIO2_500)
BOOTSPI_DQ1_BMODE1: R68.1, U18.2 (SO/IO1), U20.F6 (PS_MIO3_500)
BOOTSPI_DQ2_BMODE2: R67.1, U18.3 (~WP/IO2), U20.E4 (PS_MIO4_500)
BOOTSPI_DQ3_BMODE0: R69.1, U18.7 (~HOLD/IO3), U20.A3 (PS_MIO5_500)
BOOTSPI_SCK_BMODE4: R65.1, U18.6 (SCK), U20.A4 (PS_MIO6_500)
CLK33.33: R75.2, U17.3 (OUT)
DDR3_VTT_EN: U20.B6 (PS_MIO14_500)
GND: C10.2, C11.2, C12.2, C89.2, C90.2, C91.2, C92.2, J3.6 (VSS), J3.10 (DET_A), J3.11 (SHIELD), R65.2, R66.2, R67.2, R68.2, R70.2, R71.2, U16.1 (GND), U17.2 (GND), U18.4 (VSS), U18.9 (EP)
I2C33_SCLK: R73.2, U20.C5 (PS_MIO12_500)
I2C33_SDA: R74.2, U20.A6 (PS_MIO13_500)
unnamed: R7.1, U20.C9 (PS_SRST_B_501)
unnamed: R8.1, U20.D6 (PS_MIO16_501)
unnamed: R72.1, U17.1 (OE)
unnamed: R75.1, U20.F7 (PS_CLK_500)
SD_CD: J3.9 (DET_B), R63.2, U20.A13 (PS_MIO26_501)
SD_CLK: J3.5 (CLK), R8.2
SD_CMD: J3.3 (CMD), U20.E9 (PS_MIO17_501)
SD_D0: J3.7 (DAT0), U20.A7 (PS_MIO18_501)
SD_D1: J3.8 (DAT1), U20.E10 (PS_MIO19_501)
SD_D2: J3.1 (DAT2), U20.A8 (PS_MIO20_501)
SD_D3: J3.2 (DAT3/CD), U20.F11 (PS_MIO21_501)
UART33_RX: U16.4 (RX), U20.G7 (PS_MIO10_500)
UART33_TX: U16.5 (TX), U20.B4 (PS_MIO11_500)
VMODE0: R70.1, U20.D5 (PS_MIO7_500)
VMODE1: R71.1, U20.E5 (PS_MIO8_500)
ZYNQ_POR: U20.B5 (PS_POR_B_500)

Notes on the sheet:
Both Banks 3v3
Non-volatile memory
JTAG Signals
BOOT MODE: PLLs Enabled, JTAG Cascade, QSPI Boot
