naraprajwal/NeuraCorePCB/zynqPCB/USB.kicad_sch

## KiCad design zynqPCB/USB.kicad_sch (2026-04-12)

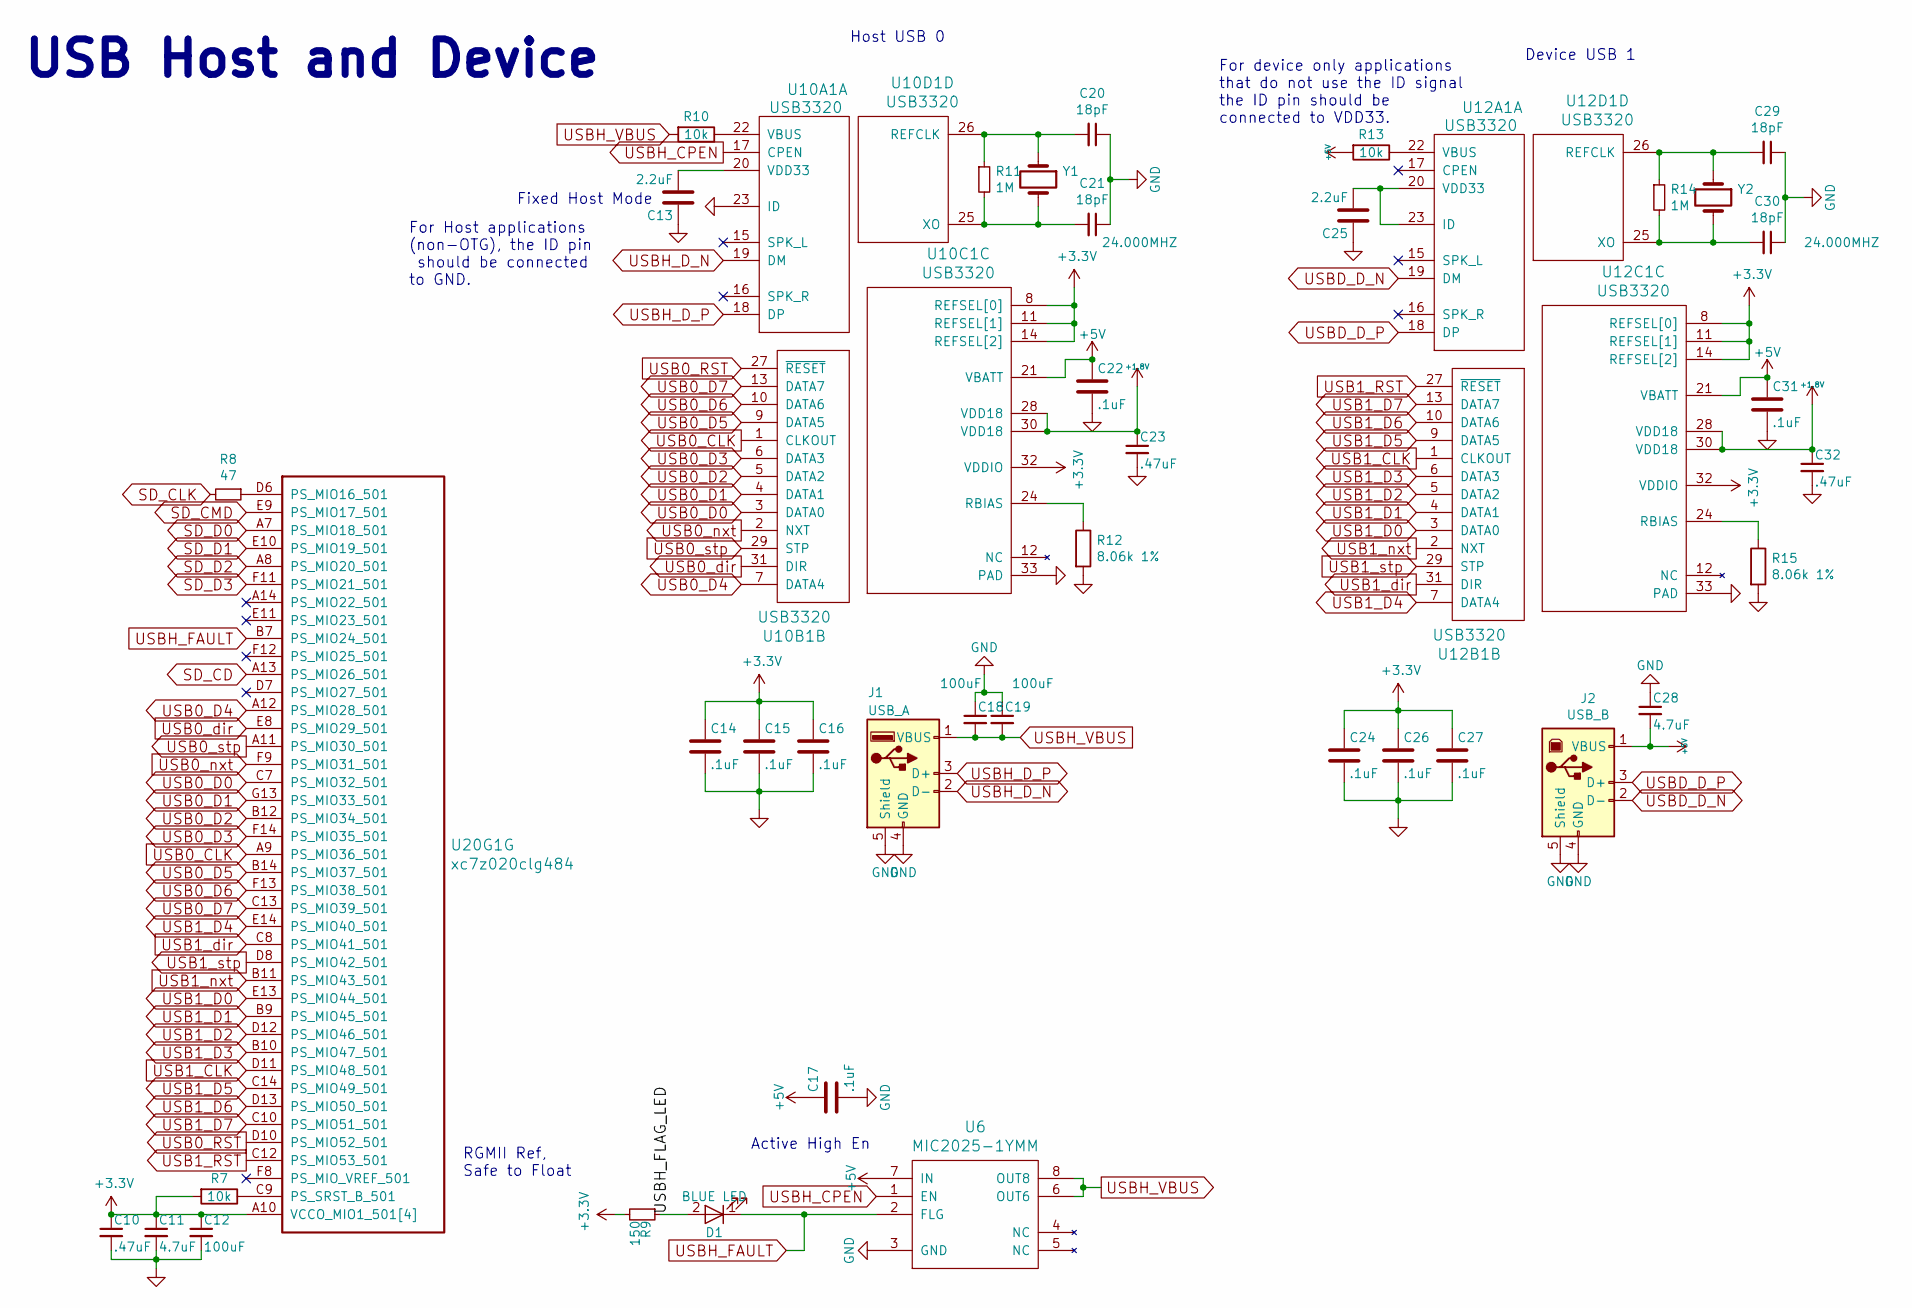
[picture p14: schematic USB.kicad_sch]

Parts:
C10, C23, C32: .47uF; C_0402_1005Metric; MPN CC0402KRX5R5BB474
C11, C28: 4.7uF; C_0402_1005Metric; MPN GRM155R60G475ME47D
C12, C18, C19: 100uF; C_1210_3225Metric; MPN JMK325ABJ107MM-P
C13, C25: 2.2uF; C_0402_1005Metric; MPN GRM155R61A225KE95D
C14, C15, C16, C17, C22, C24, C26, C27, C31: .1uF; C_0402_1005Metric; MPN CC0402KRX7R6BB104
C20, C21, C29, C30: 18pF; C_0402_1005Metric; MPN GCM1555C1H180JA16D
D1: BLUE LED; C_0603_1608Metric; MPN VLMB1300-GS08
J1: USB_A; USB-A-Receptacle-FCI_87583; MPN 87583-2010RLF
J2: USB_B; USB_B_OST_USB-B1HSxx_Horizontal; MPN USB-B1HSW6
R7, R10, R13: 10k; R_0402_1005Metric; MPN RC0402FR-0710KL
R8: 47; R_0402_1005Metric; MPN RC0402JR-0747RL
R9: 150; R_0402_1005Metric; MPN RC0402FR-07150RL
R11, R14: 1M; R_0402_1005Metric; MPN RC0402FR-071ML
R12, R15: 8.06k 1%; R_0402_1005Metric; MPN RC0402FR-078K06L
U6: MIC2025-1YMM; SOP65P490X110-8N; MPN MIC2025-1YMM-TR
U10A1, U10B1, U10C1, U10D1, U12A1, U12B1, U12C1, U12D1: USB3320; QFN-32-1EP_5x5mm_P0.5mm_EP3.1x3.1mm; MPN USB3320C-EZK-TR
U20G1: xc7z020clg484; BGA-484_19.0x19.0mm_Layout22x22_P0.80mm_dia0.40mm; MPN XC7Z020-1CLG484C
Y1, Y2: 24.000MHZ; XTAL500X320X130N; MPN ABM3-24.000MHZ-D2Y-T

Connections:
+1.8V: C23.1, C32.1, U10C1.28 (VDD18), U10C1.30 (VDD18), U12C1.28 (VDD18), U12C1.30 (VDD18)
+3.3V: C10.1, C11.1, C12.1, C14.1, C15.1, C16.1, C24.1, C26.1, C27.1, R7.2, R9.2, U10C1.8 (REFSEL[0]), U10C1.11 (REFSEL[1]), U10C1.14 (REFSEL[2]), U10C1.32 (VDDIO), U12C1.8 (REFSEL[0]), U12C1.11 (REFSEL[1]), U12C1.14 (REFSEL[2]), U12C1.32 (VDDIO), U20G1.A10 (VCCO_MIO1_501[4]), U20G1.B13 (VCCO_MIO1_501[4]), U20G1.D9 (VCCO_MIO1_501[4]), U20G1.E12 (VCCO_MIO1_501[4])
+5V: C17.1, C22.1, C28.2, C31.1, J2.1 (VBUS), R13.2, U6.7 (IN), U10C1.21 (VBATT), U12C1.21 (VBATT)
GND: C10.2, C11.2, C12.2, C13.1, C14.2, C15.2, C16.2, C17.2, C18.1, C19.1, C20.1, C21.1, C22.2, C23.2, C24.2, C25.1, C26.2, C27.2, C28.1, C29.1, C30.1, C31.2, C32.2, J1.4 (GND), J1.5 (Shield), J2.4 (GND), J2.5 (Shield), R12.2, R15.2, U6.3 (GND), U10A1.23 (ID), U10C1.33 (PAD), U12C1.33 (PAD)
unnamed: C13.2, U10A1.20 (VDD33)
unnamed: C20.2, R11.1, U10D1.26 (REFCLK), Y1.1
unnamed: C21.2, R11.2, U10D1.25 (XO), Y1.2
unnamed: C25.2, U12A1.20 (VDD33), U12A1.23 (ID)
unnamed: C29.2, R14.1, U12D1.26 (REFCLK), Y2.1
unnamed: C30.2, R14.2, U12D1.25 (XO), Y2.2
unnamed: R7.1, U20G1.C9 (PS_SRST_B_501)
unnamed: R8.1, U20G1.D6 (PS_MIO16_501)
unnamed: R10.1, U10A1.22 (VBUS)
unnamed: R12.1, U10C1.24 (RBIAS)
unnamed: R13.1, U12A1.22 (VBUS)
unnamed: R15.1, U12C1.24 (RBIAS)
SD_CD: U20G1.A13 (PS_MIO26_501)
SD_CLK: R8.2
SD_CMD: U20G1.E9 (PS_MIO17_501)
SD_D0: U20G1.A7 (PS_MIO18_501)
SD_D1: U20G1.E10 (PS_MIO19_501)
SD_D2: U20G1.A8 (PS_MIO20_501)
SD_D3: U20G1.F11 (PS_MIO21_501)
USB0_CLK: U10B1.1 (CLKOUT), U20G1.A9 (PS_MIO36_501)
USB0_D0: U10B1.3 (DATA0), U20G1.C7 (PS_MIO32_501)
USB0_D1: U10B1.4 (DATA1), U20G1.G13 (PS_MIO33_501)
USB0_D2: U10B1.5 (DATA2), U20G1.B12 (PS_MIO34_501)
USB0_D3: U10B1.6 (DATA3), U20G1.F14 (PS_MIO35_501)
USB0_D4: U10B1.7 (DATA4), U20G1.A12 (PS_MIO28_501)
USB0_D5: U10B1.9 (DATA5), U20G1.B14 (PS_MIO37_501)
USB0_D6: U10B1.10 (DATA6), U20G1.F13 (PS_MIO38_501)
USB0_D7: U10B1.13 (DATA7), U20G1.C13 (PS_MIO39_501)
USB0_RST: U10B1.27 (~RESET), U20G1.D10 (PS_MIO52_501)
USB0_dir: U10B1.31 (DIR), U20G1.E8 (PS_MIO29_501)
USB0_nxt: U10B1.2 (NXT), U20G1.F9 (PS_MIO31_501)
USB0_stp: U10B1.29 (STP), U20G1.A11 (PS_MIO30_501)
USB1_CLK: U12B1.1 (CLKOUT), U20G1.D11 (PS_MIO48_501)
USB1_D0: U12B1.3 (DATA0), U20G1.E13 (PS_MIO44_501)
USB1_D1: U12B1.4 (DATA1), U20G1.B9 (PS_MIO45_501)
USB1_D2: U12B1.5 (DATA2), U20G1.D12 (PS_MIO46_501)
USB1_D3: U12B1.6 (DATA3), U20G1.B10 (PS_MIO47_501)
USB1_D4: U12B1.7 (DATA4), U20G1.E14 (PS_MIO40_501)
USB1_D5: U12B1.9 (DATA5), U20G1.C14 (PS_MIO49_501)
USB1_D6: U12B1.10 (DATA6), U20G1.D13 (PS_MIO50_501)
USB1_D7: U12B1.13 (DATA7), U20G1.C10 (PS_MIO51_501)
USB1_RST: U12B1.27 (~RESET), U20G1.C12 (PS_MIO53_501)
USB1_dir: U12B1.31 (DIR), U20G1.C8 (PS_MIO41_501)
USB1_nxt: U12B1.2 (NXT), U20G1.B11 (PS_MIO43_501)
USB1_stp: U12B1.29 (STP), U20G1.D8 (PS_MIO42_501)
USBD_D_N: J2.2 (D-), U12A1.19 (DM)
USBD_D_P: J2.3 (D+), U12A1.18 (DP)
USBH_CPEN: U6.1 (EN), U10A1.17 (CPEN)
USBH_D_N: J1.2 (D-), U10A1.19 (DM)
USBH_D_P: J1.3 (D+), U10A1.18 (DP)
USBH_FAULT: D1.1 (K), U6.2 (FLG), U20G1.B7 (PS_MIO24_501)
USBH_FLAG_LED: D1.2 (A), R9.1
USBH_VBUS: C18.2, C19.2, J1.1 (VBUS), R10.2, U6.6 (OUT6), U6.8 (OUT8)

Notes on the sheet:
USB Host and Device
Host USB 0
For device only applications that do not use the ID signal the ID pin should be connected to VDD33.
RGMII Ref, Safe to Float
Active High En
Device USB 1
Fixed Host Mode
For Host applications (non-OTG), the ID pin should be connected to GND.
