naraprajwal/NeuraCorePCB/zynqPCB/power.kicad_sch

## KiCad design zynqPCB/power.kicad_sch (2026-04-15)

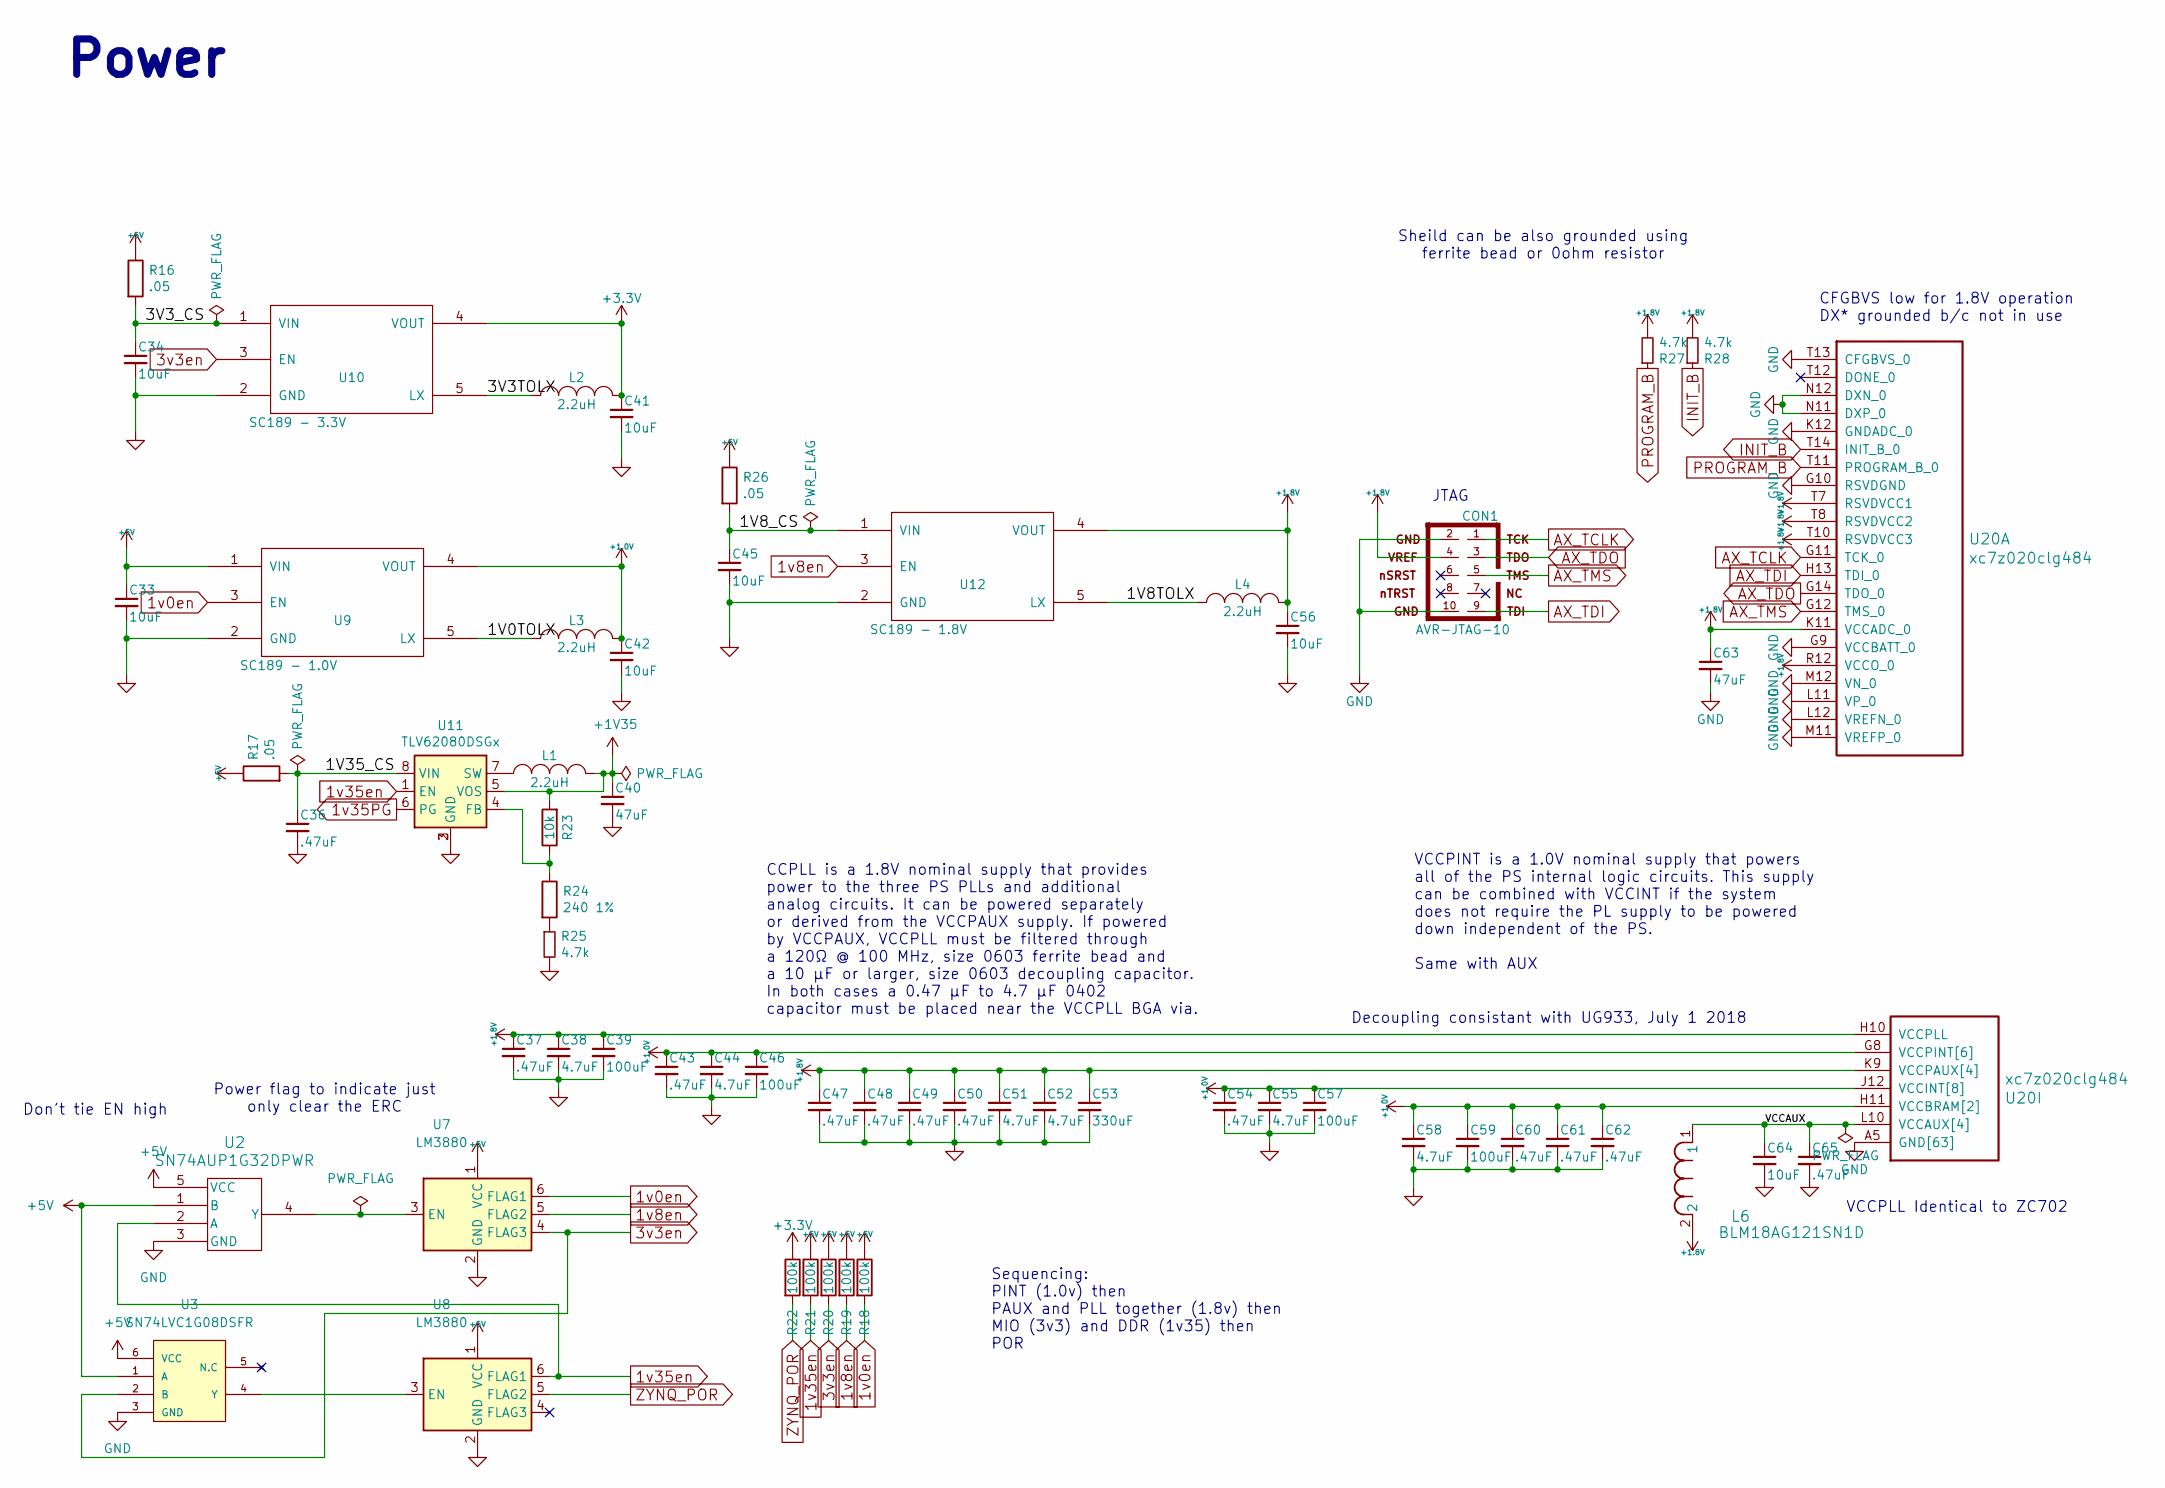
[picture p15: schematic power.kicad_sch]

Parts:
C33, C34, C41, C42, C45, C56, C64: 10uF; C_0603_1608Metric; MPN GRM188R61A106KE69J
C36, C37, C43, C47, C48, C49, C50, C54, C60, C61, C62, C65: .47uF; C_0402_1005Metric; MPN CC0402KRX5R5BB474
C38, C44, C51, C52, C55, C58: 4.7uF; C_0402_1005Metric; MPN GRM155R60G475ME47D
C39, C46, C57, C59: 100uF; C_1210_3225Metric; MPN JMK325ABJ107MM-P
C40, C63: 47uF; C_0805_2012Metric; MPN GRM219R60J476ME44D
C53: 330uF; C_1206_3216Metric; MPN F950G337MAAAQ2
CON1: AVR-JTAG-10; XilinxJTAG
L1, L2, L3, L4: 2.2uH; C_1812_4532Metric; MPN LQH43PN2R2M26L
L6: BLM18AG121SN1D; IND_BLM18_0603_MUR-L
R16, R17, R26: .05; R_2512_6332Metric; MPN CRA2512-FZ-R050ELF
R18, R19, R20, R21, R22: 100k; R_0402_1005Metric; MPN RC0402FR-07100KL
R23: 10k; R_0402_1005Metric; MPN RC0402FR-0710KL
R24: 240 1%; R_0402_1005Metric; MPN RC0402FR-07240RL
R25, R27, R28: 4.7k; R_0402_1005Metric; MPN RC0402JR-074K7L
U2: SN74AUP1G32DPWR; DPW0005A_TEX
U3: SN74LVC1G08DSFR; SON35P100X100X40-6N; MPN SN74LVC1G08DSFR; DigiKey_Part_Number 296-28375-1-ND
U7, U8: LM3880; SOT-23-6; MPN LM3880MF-1AE/NOPB
U9: SC189 - 1.0V; SOT-23-5; MPN SC189ASKTRT
U10: SC189 - 3.3V; SOT-23-5; MPN SC189ZSKTRT
U11: TLV62080DSGx; WSON-8-1EP_2x2mm_P0.5mm_EP0.9x1.6mm; MPN TLV62080DSGR
U12: SC189 - 1.8V; SOT-23-5; MPN SC189LSKTRT
U20: xc7z020clg484; BGA-484_19.0x19.0mm_Layout22x22_P0.80mm_dia0.40mm; MPN XC7Z020-1CLG484C

Connections:
1V0TOLX: L3.1, U9.5 (LX)
1V8TOLX: L4.1, U12.5 (LX)
1V8_CS: C45.1, R26.2, U12.1 (VIN)
1V35_CS: C36.1, R17.2, U11.8 (VIN)
1v0en: R18.2, U7.6 (FLAG1), U9.3 (EN)
1v8en: R19.2, U7.5 (FLAG2), U12.3 (EN)
1v35PG: U11.6 (PG)
1v35en: R21.2, U2.2 (A), U8.6 (FLAG1), U11.1 (EN)
3V3TOLX: L2.1, U10.5 (LX)
3V3_CS: C34.1, R16.2, U10.1 (VIN)
3v3en: R20.2, U3.2 (B), U7.4 (FLAG3), U10.3 (EN)
+1.0V: C42.1, C43.1, C44.1, C46.1, C54.1, C55.1, C57.1, C58.1, C59.1, C60.1, C61.1, C62.1, L3.2, U9.4 (VOUT), U20.G8 (VCCPINT[6]), U20.H9 (VCCPINT[6]), U20.H11 (VCCBRAM[2]), U20.J8 (VCCPINT[6]), U20.J10 (VCCBRAM[2]), U20.J12 (VCCINT[8]), U20.J14 (VCCINT[8]), U20.K13 (VCCINT[8]), U20.L8 (VCCPINT[6]), U20.L14 (VCCINT[8]), U20.M13 (VCCINT[8]), U20.N8 (VCCPINT[6]), U20.N14 (VCCINT[8]), U20.P13 (VCCINT[8]), U20.R8 (VCCPINT[6]), U20.R14 (VCCINT[8])
+1.8V: C37.1, C38.1, C39.1, C47.1, C48.1, C49.1, C50.1, C51.1, C52.1, C53.1, C56.1, C63.1, CON1.4, L4.2, L6.2, R27.2, R28.2, U12.4 (VOUT), U20.H10 (VCCPLL), U20.K9 (VCCPAUX[4]), U20.K11 (VCCADC_0), U20.M9 (VCCPAUX[4]), U20.P9 (VCCPAUX[4]), U20.R12 (VCCO_0), U20.T7 (RSVDVCC1), U20.T8 (RSVDVCC2), U20.T9 (VCCPAUX[4]), U20.T10 (RSVDVCC3)
+1V35: C40.1, L1.2, R23.2, U11.5 (VOS)
+3.3V: C41.1, L2.2, R22.1, U10.4 (VOUT)
+5V: C33.1, R16.1, R17.1, R18.1, R19.1, R20.1, R21.1, R26.1, U2.1 (B), U2.5 (VCC), U3.1 (A), U3.6 (VCC), U7.1 (VCC), U8.1 (VCC), U9.1 (VIN)
AX_TCLK: CON1.1, U20.G11 (TCK_0)
AX_TDI: CON1.9, U20.H13 (TDI_0)
AX_TDO: CON1.3, U20.G14 (TDO_0)
AX_TMS: CON1.5, U20.G12 (TMS_0)
GND: C33.2, C34.2, C36.2, C37.2, C38.2, C39.2, C40.2, C41.2, C42.2, C43.2, C44.2, C45.2, C46.2, C47.2, C48.2, C49.2, C50.2, C51.2, C52.2, C53.2, C54.2, C55.2, C56.2, C57.2, C58.2, C59.2, C60.2, C61.2, C62.2, C63.2, C64.2, C65.2, CON1.2, CON1.10, R25.2, U2.3 (GND), U3.3 (GND), U7.2 (GND), U8.2 (GND), U9.2 (GND), U10.2 (GND), U11.2 (GND), U11.3 (GND), U11.9 (GND), U12.2 (GND), U20.A5 (GND[63]), U20.A15 (GND[63]), U20.AA5 (GND[63]), U20.AA15 (GND[63]), U20.AB8 (GND[63]), U20.AB18 (GND[63]), U20.B8 (GND[63]), U20.B18 (GND[63]), U20.C1 (GND[63]), U20.C11 (GND[63]), U20.C21 (GND[63]), U20.D4 (GND[63]), U20.D14 (GND[63]), U20.E7 (GND[63]), U20.E17 (GND[63]), U20.F10 (GND[63]), U20.F20 (GND[63]), U20.G3 (GND[63]), U20.G9 (VCCBATT_0), U20.G10 (RSVDGND), U20.H6 (GND[63]), U20.H8 (GND[63]), U20.H12 (GND[63]), U20.H14 (GND[63]), U20.H16 (GND[63]), U20.J9 (GND[63]), U20.J11 (GND[63]), U20.J13 (GND[63]), U20.J19 (GND[63]), U20.K2 (GND[63]), U20.K8 (GND[63]), U20.K10 (GND[63]), U20.K12 (GNDADC_0), U20.K14 (GND[63]), U20.K22 (GND[63]), U20.L5 (GND[63]), U20.L9 (GND[63]), U20.L11 (VP_0), U20.L12 (VREFN_0), U20.L13 (GND[63]), U20.L15 (GND[63]), U20.M8 (GND[63]), U20.M10 (GND[63]), U20.M11 (VREFP_0), U20.M12 (VN_0), U20.M14 (GND[63]), U20.M18 (GND[63]), U20.N1 (GND[63]), U20.N9 (GND[63]), U20.N11 (DXP_0), U20.N12 (DXN_0), U20.N13 (GND[63]), U20.N21 (GND[63]), U20.P4 (GND[63]), U20.P8 (GND[63]), U20.P10 (GND[63]), U20.P12 (GND[63]), U20.P14 (GND[63]), U20.R9 (GND[63]), U20.R11 (GND[63]), U20.R13 (GND[63]), U20.R17 (GND[63]), U20.T13 (CFGBVS_0), U20.T20 (GND[63]), U20.U3 (GND[63]), U20.U13 (GND[63]), U20.V6 (GND[63]), U20.V16 (GND[63]), U20.W9 (GND[63]), U20.W19 (GND[63]), U20.Y2 (GND[63]), U20.Y12 (GND[63]), U20.Y22 (GND[63])
INIT_B: R28.1, U20.T14 (INIT_B_0)
unnamed: L1.1, U11.7 (SW)
unnamed: R23.1, R24.1, U11.4 (FB)
unnamed: R24.2, R25.1
unnamed: U2.4 (Y), U7.3 (EN)
unnamed: U3.4 (Y), U8.3 (EN)
PROGRAM_B: R27.1, U20.T11 (PROGRAM_B_0)
VCCAUX: C64.1, C65.1, L6.1, U20.L10 (VCCAUX[4]), U20.N10 (VCCAUX[4]), U20.P11 (VCCAUX[4]), U20.R10 (VCCAUX[4])
ZYNQ_POR: R22.2, U8.5 (FLAG2)

Notes on the sheet:
JTAG
Sequencing: PINT (1.0v) then PAUX and PLL together (1.8v) then MIO (3v3) and DDR (1v35) then POR
CFGBVS low for 1.8V operation DX* grounded b/c not in use
VCCPLL Identical to ZC702
Don't tie EN high
CCPLL is a 1.8V nominal supply that provides power to the three PS PLLs and additional analog circuits. It can be powered separately or derived from the VCCPAUX supply. If powered by VCCPAUX, VCCPLL must be filtered through a 120Ω @ 100 MHz, size 0603 ferrite bead and a 10 µF or larger, size 0603 d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
Power flag to indicate just only clear the ERC
Decoupling consistant with UG933, July 1 2018
VCCPINT is a 1.0V nominal supply that powers all of the PS internal logic circuits. This supply can be combined with VCCINT if the system does not require the PL supply to be powered down independent of the PS. Same with AUX
Sheild can be also grounded using ferrite bead or 0ohm resistor
Power
