naraprajwal/NeuraCorePCB/zynqPCB/sensors.kicad_sch

## KiCad design zynqPCB/sensors.kicad_sch (2026-03-16)

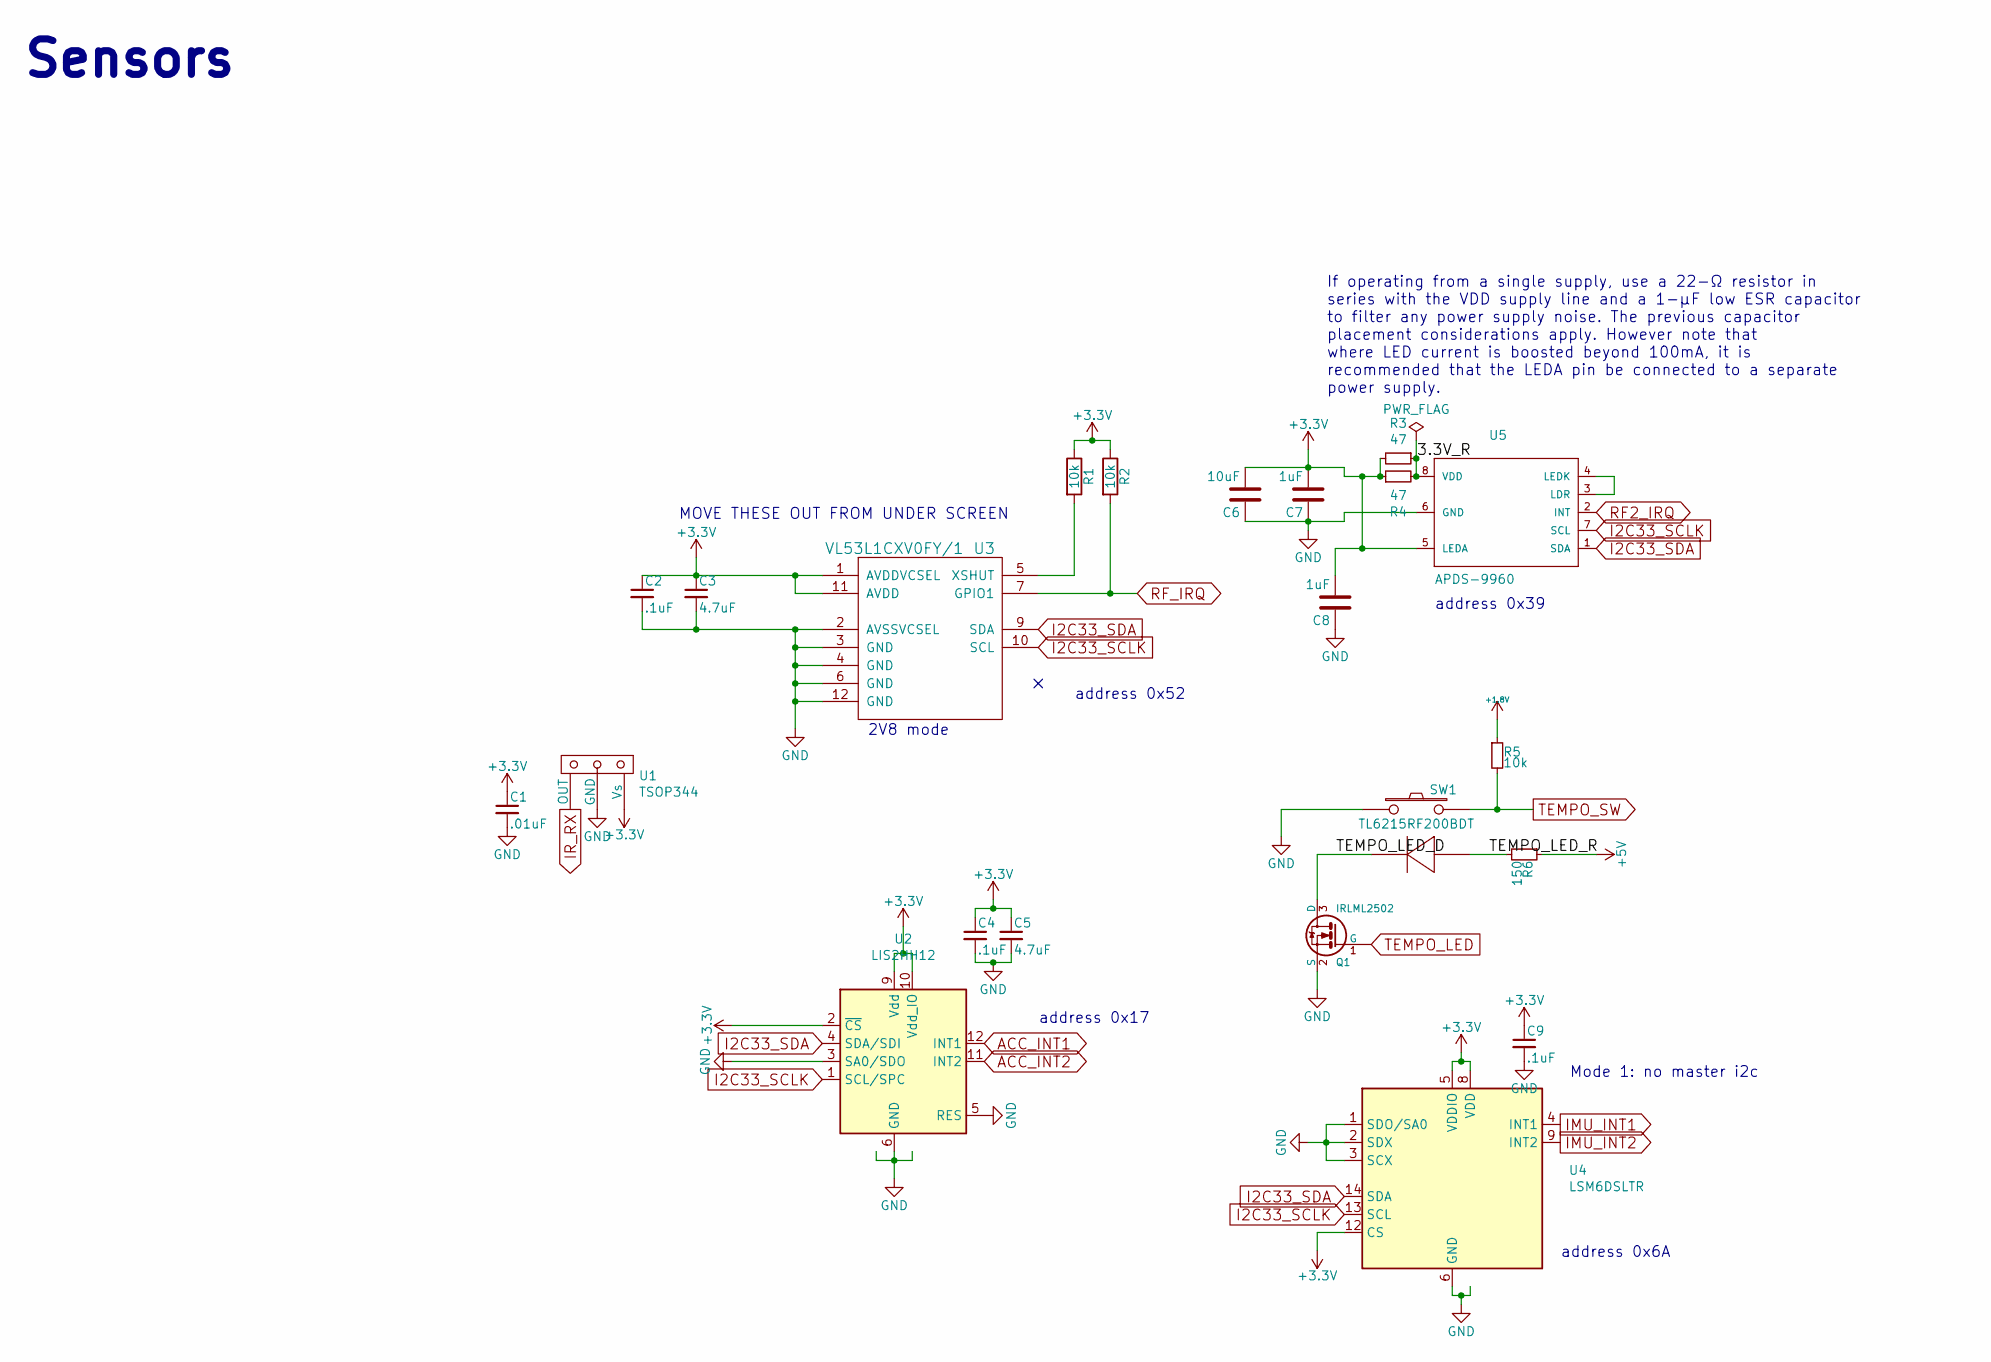
[picture p16: schematic sensors.kicad_sch]

Parts:
C1: .01uF; C_0402_1005Metric; MPN GRM155R71H103KA88J
C2, C4, C9: .1uF; C_0402_1005Metric; MPN CC0402KRX7R6BB104
C3, C5: 4.7uF; C_0402_1005Metric; MPN GRM155R60G475ME47D
C6: 10uF; C_0603_1608Metric; MPN GRM188R61A106KE69J
C7, C8: 1uF; C_0402_1005Metric; MPN CC0402KRX5R6BB105
Q1: IRLML2502; SOT-23; MPN IRLML2502TRPBF
R1, R2, R5: 10k; R_0402_1005Metric; MPN RC0402FR-0710KL
R3, R4: 47; R_0402_1005Metric; MPN RC0402JR-0747RL
R6: 150; R_0402_1005Metric; MPN RC0402FR-07150RL
SW1: TL6215RF200BDT; tl6215_right_angle; MPN TL6215RF200BDT
U1: TSOP344; JUMPER_3PIN; MPN TSOP34438
U2: LIS2HH12; LGA-12_2x2mm_P0.5mm; MPN LIS2HH12TR
U3: VL53L1CXV0FY/1; Optical_LGA12; MPN VL53L1CXV0FY/1
U4: LSM6DSLTR; LGA-14_3x2.5mm_P0.5mm_LayoutBorder3x4y; MPN LSM6DSLTR
U5: APDS-9960; APDS_9960; MPN APDS-9960

Connections:
3.3V_R: R3.1, R4.2, U5.8 (VDD)
+1.8V: R5.1
+3.3V: C1.1, C2.1, C3.1, C4.1, C5.1, C6.2, C7.2, C8.2, C9.1, R1.1, R2.1, R3.2, R4.1, U1.3 (Vs), U2.2 (~CS), U2.9 (Vdd), U2.10 (Vdd_IO), U3.1 (AVDDVCSEL), U3.11 (AVDD), U4.5 (VDDIO), U4.8 (VDD), U4.12 (CS), U5.5 (LEDA)
+5V: R6.1
ACC_INT1: U2.12 (INT1)
ACC_INT2: U2.11 (INT2)
GND: C1.2, C2.2, C3.2, C4.2, C5.2, C6.1, C7.1, C8.1, C9.2, Q1.2 (S), SW1.1, U1.2 (GND), U2.3 (SA0/SDO), U2.5 (RES), U2.6 (GND), U2.7 (GND), U2.8 (GND), U3.2 (AVSSVCSEL), U3.3 (GND), U3.4 (GND), U3.6 (GND), U3.12 (GND), U4.1 (SDO/SA0), U4.2 (SDX), U4.3 (SCX), U4.6 (GND), U4.7 (GND), U5.6 (GND)
I2C33_SCLK: U2.1 (SCL/SPC), U3.10 (SCL), U4.13 (SCL), U5.7 (SCL)
I2C33_SDA: U2.4 (SDA/SDI), U3.9 (SDA), U4.14 (SDA), U5.1 (SDA)
IMU_INT1: U4.4 (INT1)
IMU_INT2: U4.9 (INT2)
IR_RX: U1.1 (OUT)
unnamed: R1.2, U3.5 (XSHUT)
unnamed: U5.3 (LDR), U5.4 (LEDK)
RF2_IRQ: U5.2 (INT)
RF_IRQ: R2.2, U3.7 (GPIO1)
TEMPO_LED: Q1.1 (G)
TEMPO_LED_D: Q1.3 (D), SW1.3
TEMPO_LED_R: R6.2, SW1.4
TEMPO_SW: R5.2, SW1.2

Notes on the sheet:
Sensors
MOVE THESE OUT FROM UNDER SCREEN
address 0x39
Mode 1: no master i2c
address 0x17
If operating from a single supply, use a 22-Ω resistor in series with the VDD supply line and a 1-μF low ESR capacitor to filter any power supply noise. The previous capacitor placement considerations apply. However note that where LED current is boosted beyond 100mA, it is recommended that the LED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
address 0x6A
address 0x52
2V8 mode
