naraprajwal/NeuraCorePCB/(commit log)

2026-03-16 DDR3 Changes
    [Audio.kicad_sch, Audio.sch, DDR3.kicad_sch, DDR3.sch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]
2026-03-16 Sensores Removed
    [Audio.kicad_sch, DFTBoard.kicad_sch, LCD50.kicad_sch, Storage.kicad_sch, USB.kicad_sch, power.kicad_sch]
2026-03-18 update audio
    [Audio.kicad_sch]
2026-03-22 sensor changed
    [Audio.kicad_sch, LCD50.kicad_sch, Storage.kicad_sch]
2026-03-24 removed grounded resistor can configure from the vivado and removed LCD
    [Audio.kicad_sch]
2026-03-24 Audio removed
    [Audio.kicad_sch]
2026-03-26 audio capacitors
    [Audio.kicad_sch]
2026-04-12 Camera added
    [Audio.kicad_sch, DDR3.kicad_sch, DFTBoard.kicad_sch, LCD50.kicad_sch, Storage.kicad_sch, USB.kicad_sch, power.kicad_sch]
2026-04-13 USB-c power port
    [power.kicad_sch]
2026-04-14 Cleared ERC error except the sequencer Part
    [Camera.kicad_sch, DDR3.kicad_sch, DFTBoard.kicad_sch, Storage.kicad_sch, Unplacedpowerpins.kicad_sch, power.kicad_sch]
2026-04-14 Button added for the capturing the image
2026-04-14 Sequencing is taken care
    [Camera.kicad_sch, DFTBoard.kicad_sch, power.kicad_sch]
2026-04-15 Sanity Checks and added some footprints
    [Camera.kicad_sch, DDR3.kicad_sch, DFTBoard.kicad_sch, HDMI.kicad_sch, Power_input_usb-c.kicad_sch, power.kicad_sch]
2026-04-15 Footprint edits
2026-04-15 Ferrite Bead
    [Camera.kicad_sch, Power_input_usb-c.kicad_sch, power.kicad_sch]
